OpenHaunt/node/hardware/ToDo-assets/crystal-caps-in-path.png

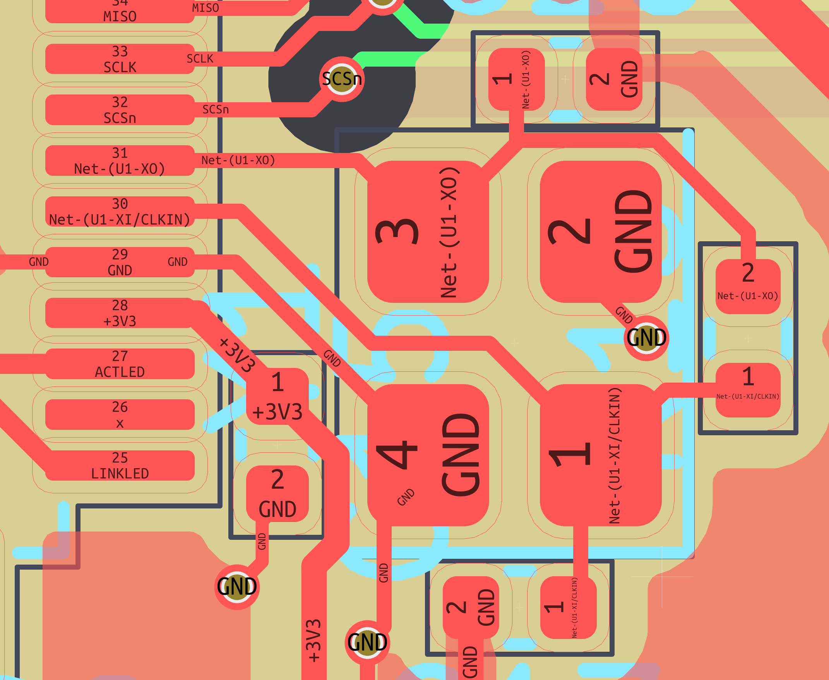
hardware/ToDo-assets/crystal-caps-in-path.png
