OpenHaunt/node/hardware/ToDo-assets/dangling-ends.png

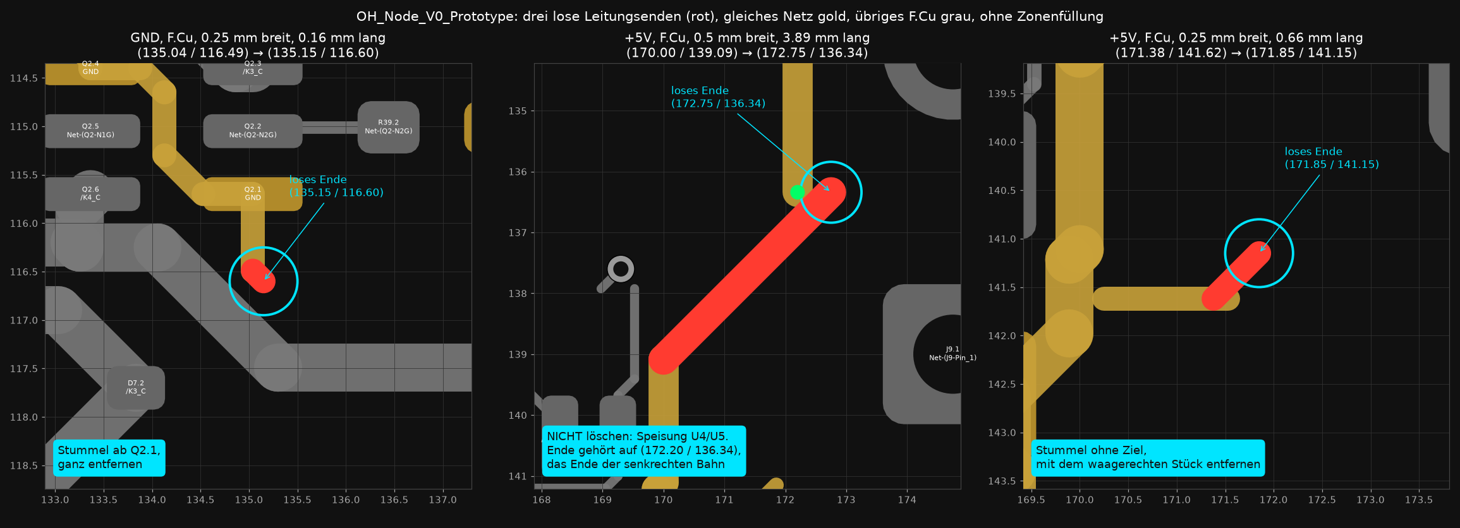
hardware/ToDo-assets/dangling-ends.png
