OpenHaunt/node/hardware/ToDo-assets/eth-pair-3v3a-via.png

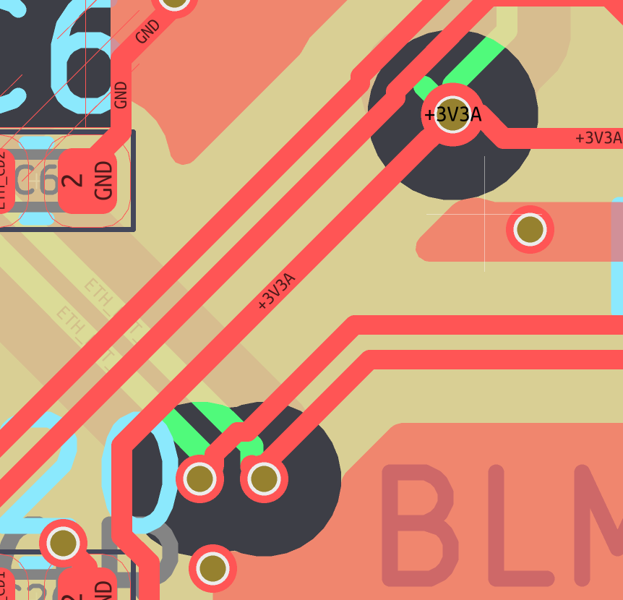
hardware/ToDo-assets/eth-pair-3v3a-via.png
