OpenHaunt/node/hardware/ToDo-assets/gnd-zone-settings.png

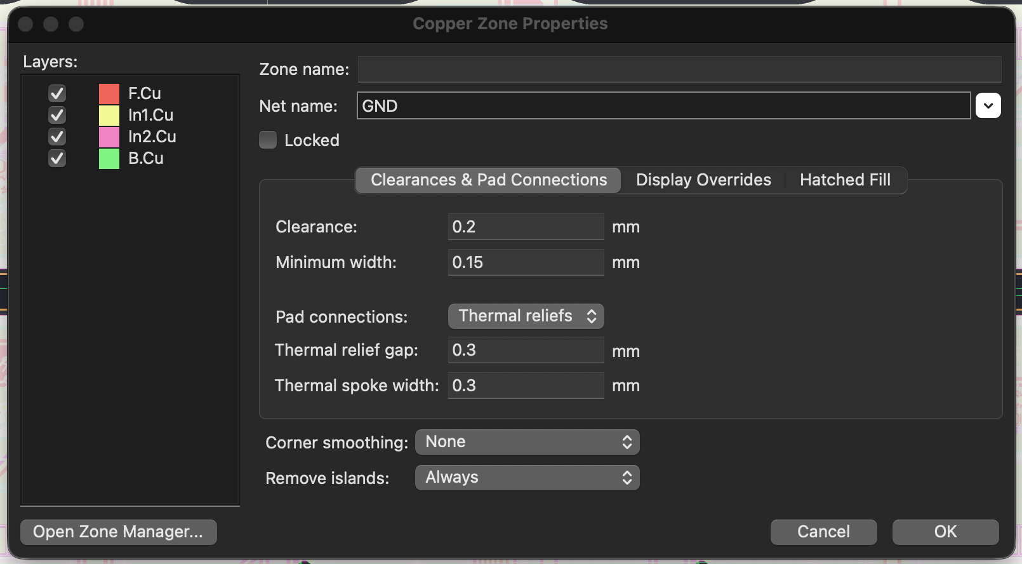
hardware/ToDo-assets/gnd-zone-settings.png
