OpenHaunt/node/hardware/ToDo-assets/k3-a1-connection.png

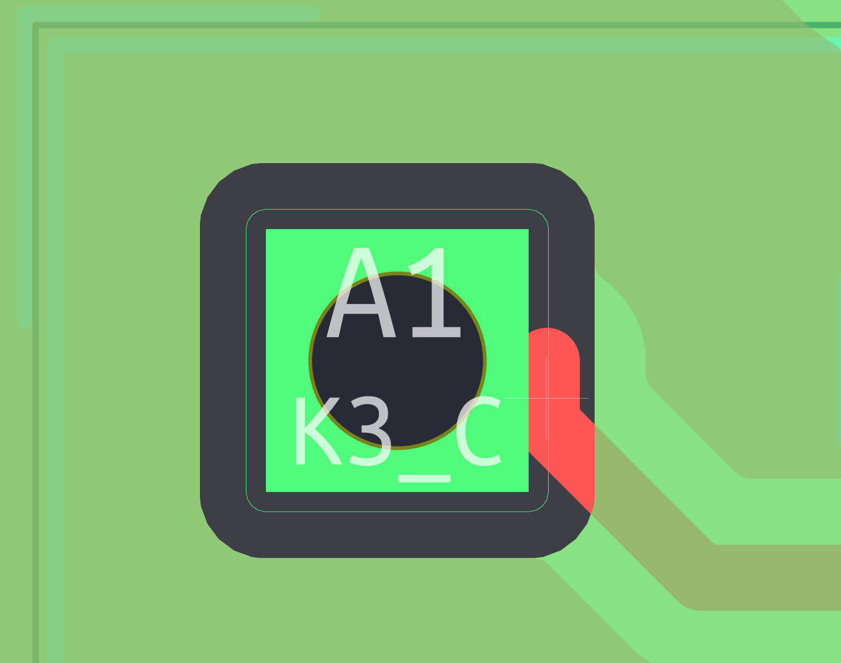
hardware/ToDo-assets/k3-a1-connection.png
