OpenHaunt/node/hardware/ToDo-assets/stitching-near-gnd-pads.png

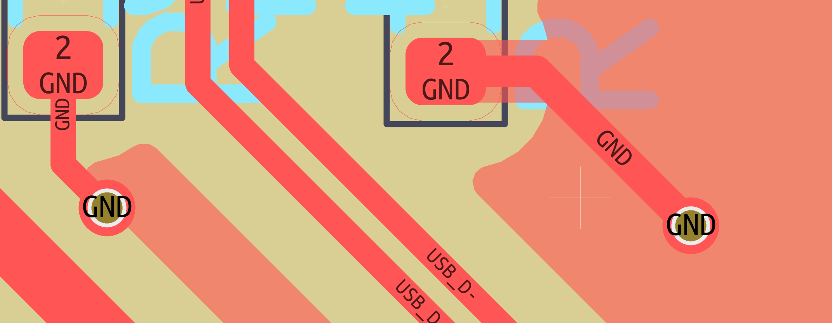
hardware/ToDo-assets/stitching-near-gnd-pads.png
