OpenHaunt/node/hardware/ToDo-assets/thin-traces-io0.png

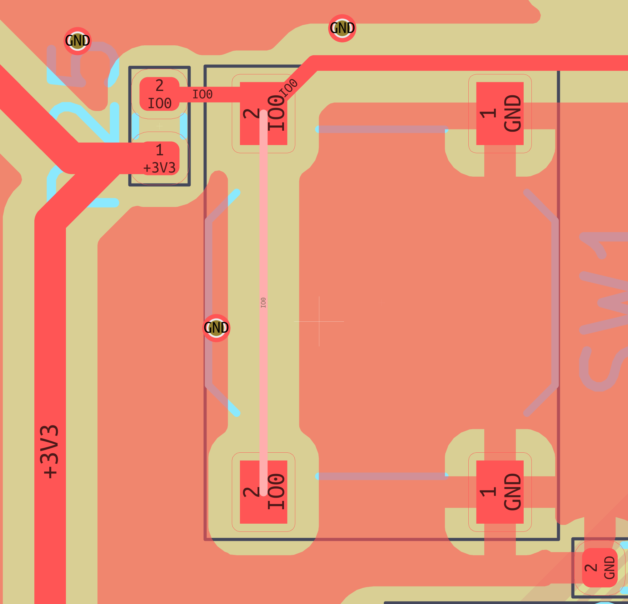
hardware/ToDo-assets/thin-traces-io0.png
