OpenHaunt/node/hardware/ToDo-assets/tvs-on-branch.png

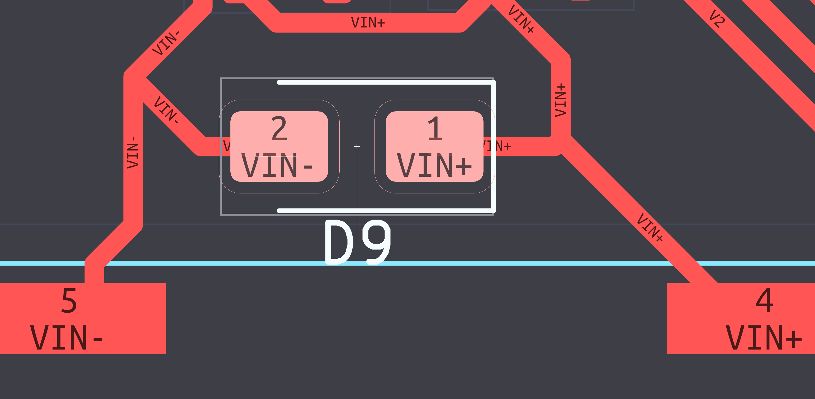
hardware/ToDo-assets/tvs-on-branch.png
