OpenHaunt/node/hardware/ToDo-assets/via-stitching-plugin.png

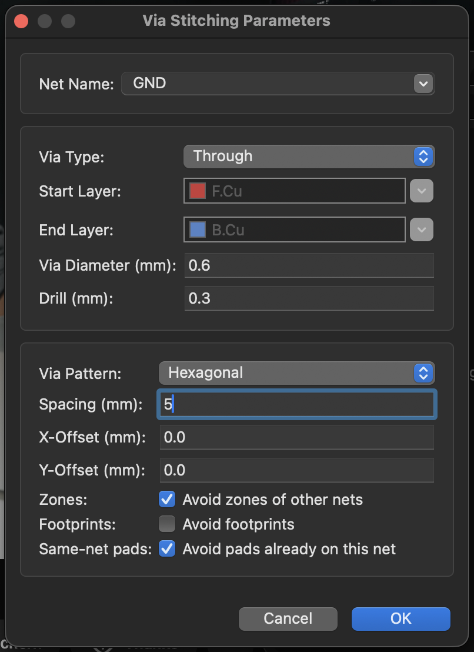
hardware/ToDo-assets/via-stitching-plugin.png
