OpenHaunt/node/hardware/ToDo-assets/zone-finger-corner.png

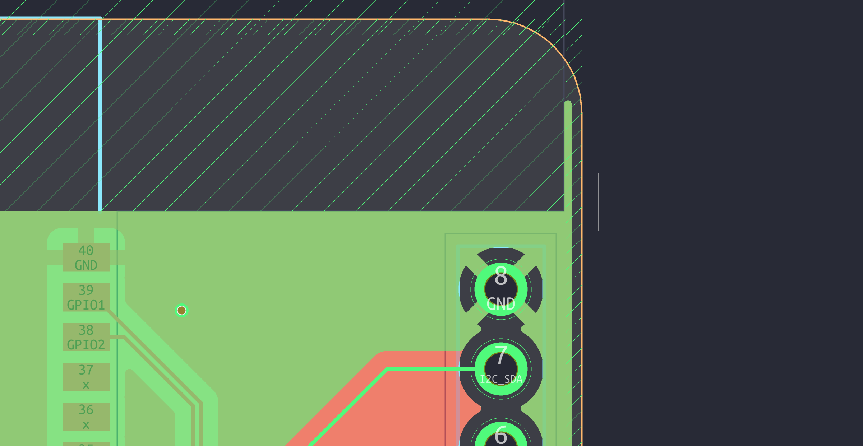
hardware/ToDo-assets/zone-finger-corner.png
