OpenHaunt/node/hardware/OH_Node_V0_Prototype/production/jlc_final/hand_parts.md

# Hand-soldered THT parts — 5 board(s), DigiKey prices (EUR) fetched 2026-10-17

Generated by `scripts/hand_parts.py --boards 5 --spares`. Order = needed + spares (1 from €5 unit price, 2 from €1, 3 below); cost = order × unit price at that quantity.

## From DigiKey

Cart upload: `hand_parts_digikey.csv`.

| Refs | Per board | Needed | Spares | Order | Part | Manufacturer | Part-DB | DigiKey | DK stock | € unit | € order |
|---|---|---|---|---|---|---|---|---|---|---|---|
| J1 | 1 | 5 | 3 | 8 | STX-3000 | Kycon, Inc. | 617 | 2092-STX-3000-ND | 59316 | 0.6 | 4.8 |
| K1, K2, K3, K4 | 4 | 20 | 2 | 22 | G2RL-1-E DC5 | Aratas (Formerly Omron Components) | 583 | Z2824-ND | 9626 | 3.21 | 70.62 |
| PS1 | 1 | 5 | 1 | 6 | AG9905-MTB | Silvertel | 577 | 5061-AG9905-MTB-ND | 6353 | 7.68 | 46.08 |

**DigiKey cost for 5 board(s): €121.50**, excl. shipping/VAT.

## From Würth Elektronik directly

Order list: `hand_parts_wurth.csv` (order code = MPN). The DigiKey prices are a reference only.

| Refs | Per board | Needed | Spares | Order | Part | Manufacturer | Part-DB | DigiKey | DK stock | € unit | € order |
|---|---|---|---|---|---|---|---|---|---|---|---|
| J2, J4, J5, J6, J8, J10 | 6 | 30 | 3 | 33 | 691137710003 | Würth Elektronik | 584 | 732-10956-ND | 14546 | 0.489 | 16.14 |
| J3 | 1 | 5 | 1 | 6 | 7499511420 | Würth Elektronik | 159 | 732-7499511420-ND | 84 | 13.756 | 82.54 |
| J7, J9, J13 | 3 | 15 | 3 | 18 | 691137710002 | Würth Elektronik | 585 | 732-10955-ND | 66147 | 0.303 | 5.45 |
| J12 | 1 | 5 | 3 | 8 | 61300811121 | Würth Elektronik | 34 | 732-5321-ND | 40836 | 0.33 | 2.64 |

Reference at DigiKey prices: €106.77.

Plus the enclosure hardware per board (4 × M2.5 × 25 screws through H1–H4, 4 × M2.5 heat-set inserts, wall screws): see `enclosure/v0.2/README.md`.

DNP, not fitted: R5, R9, R10, R11, R12, R13, R14, R47, R48, R50.
