OpenHaunt/node/hardware/OH_Node_V0_Prototype/production/jlc_final/bom.csv

Comment | Designator | Footprint | LCSC Part # | MPN
1n 2kV | C1 | C_1206_3216Metric | C9196 | 1206B102K202NT
100u/25V | C2 | CP_Elec_6.3x7.7 | C50146718 | FP-025ME101M-SAR
22u/25V | C3,C4,C25,C31,C34,C35,C36,C37 | C_0805_2012Metric | C45783 | CL21A226MAQNNNE
10u | C5,C27,C33,C43,C49,C50 | C_0402_1005Metric | C408132 | GRM155R61A106ME11D
100n/50V | C6,C7,C8,C9,C10,C11,C12,C15,C20,C26,C28,C29,C32,C38,C40,C41,C42,C44 | C_0402_1005Metric | C307331 | CL05B104KB54PNC
1u/25V | C13,C14,C24,C39,C51,C52 | C_0402_1005Metric | C52923 | CL05A105KA5NQNC
10n | C16,C30 | C_0402_1005Metric | C15195 | CL05B103KB5NNNC
27p | C17,C18 | C_0402_1005Metric | C1557 | 0402CG270J500NT
4.7u | C19 | C_0805_2012Metric | C1779 | CL21A475KAQNNNE
100u | C21 | C_1206_3216Metric | C883598 | GRM31CR61A107MEA8L
6n8 | C22,C23 | C_0402_1005Metric | C1542 | 0402B682K500NT
2u2 | C45,C48 | C_0603_1608Metric | C23630 | CL10A225KO8NNNC
2n2 | C46,C47 | C_0402_1005Metric | C1531 | 0402B222K500NT
KT-0603Y | D1 | LED_0603_1608Metric | C2287 | KT-0603Y
KT-0603R | D2,D3,D4,D14,D15 | LED_0603_1608Metric | C2286 | KT-0603R
1N4148WS | D5,D6,D7,D8,D18,D19 | D_SOD-323 | C2128 | 1N4148WS
SMAJ58A | D9 | D_SMA | C19077554 | SMAJ58A
MB10S-50MIL | D11,D12 | TO-269AA | C2488 | MB10S-50MIL
KT-0805Y | D16,D17 | LED_0805_2012Metric | C2296 | KT-0805Y
B5819W SL | D21 | D_SOD-123 | C8598 | B5819W SL
0805L020/30XR | F1,F2 | Fuse_0805_2012Metric | C7472560 | 0805L020/30XR
USB4215-03-A | J11 | USB_C_Receptacle_GCT_USB4215-xx-A_16P_TopMnt_Horizontal | C37616412 | USB4215-03-A
BLM15AG601SN1D | L1,L3 | L_0402_1005Metric | C76884 | BLM15AG601SN1D
10u | L2 | L_Sunlord_SWPA4030S | C38117 | SWPA4030S100MT
DMN2004DWK-7 | Q1,Q2 | SOT-363_SC-70-6 | C156343 | DMN2004DWK-7
MMBT3904 | Q3,Q4 | SOT-23 | C20526 | MMBT3904
1M | R1 | R_0603_1608Metric | C22935 | 0603WAF1004T5E
4K7 | R2,R3 | R_0402_1005Metric | C25900 | 0402WGF4701TCE
10R | R4 | R_0402_1005Metric | C25077 | 0402WGF100JTCE
5K1 | R6,R7 | R_0402_1005Metric | C25905 | 0402WGF5101TCE
12k4 | R8 | R_0402_1005Metric | C11692 | 0402WGF1242TCE
1M | R15 | R_0402_1005Metric | C26083 | 0402WGF1004TCE
0R | R16,R17,R18,R19 | R_0402_1005Metric | C17168 | 0402WGF0000TCE
10K | R20,R22,R23,R24,R25,R31,R32,R34,R35,R36,R37,R38,R41,R49,R58,R60,R61,R66,R70 | R_0402_1005Metric | C25744 | 0402WGF1002TCE
49R9 | R21,R42,R43,R44 | R_0402_1005Metric | C25120 | 0402WGF499JTCE
150R | R26,R27,R28,R33 | R_0402_1005Metric | C25082 | 0402WGF1500TCE
1K | R29,R30,R39,R40,R45,R46,R51,R52,R53,R54,R55,R56,R71 | R_0402_1005Metric | C11702 | 0402WGF1001TCE
100K | R57,R59 | R_0402_1005Metric | C25741 | 0402WGF1003TCE
470R | R62,R63 | R_0402_1005Metric | C25117 | 0402WGF4700TCE
51K | R64 | R_0603_1608Metric | C23196 | 0603WAF5102T5E
2K7 | R65 | R_0603_1608Metric | C13167 | 0603WAF2701T5E
47K | R67,R69 | R_0402_1005Metric | C25792 | 0402WGF4702TCE
12K | R68 | R_0402_1005Metric | C25752 | 0402WGF1202TCE
Push | SW1,SW2 | SW_Push_1P1T_XKB_TS-1187A | C318884 | TS-1187A-B-A-B
W5500 | U1 | LQFP-48_7x7mm_P0.5mm | C32843 | W5500
ESP32-S3-WROOM-1-N16R2 | U2 | Espressif_ESP32-S3-WROOM-1 | C2913205 | ESP32-S3-WROOM-1-N16R2
AMS1117-3.3 | U3 | SOT-223-3_TabPin2 | C347222 | AMS1117-3.3
74AHCT1G125W5-7 | U4,U5 | SOT-23-5 | C842287 | 74AHCT1G125W5-7
MAX98357AETE+T | U6 | TQFN-16-1EP_3x3mm_P0.5mm_EP1.23x1.23mm | C910544 | MAX98357AETE+T
MT3608 | U7 | SOT-23-6 | C84817 | MT3608
TPS2121RUXR | U8 | Texas_VQFN-HR-12_2x2.5mm_P0.5mm | C485916 | TPS2121RUXR
PCM5102APWR | U9 | TSSOP-20_4.4x6.5mm_P0.65mm | C107671 | PCM5102APWR
CJ431 | U10 | SOT-23 | C3113 | CJ431
ECS-250-18-33-JGN-TR3 | Y1 | Crystal_SMD_3225-4Pin_3.2x2.5mm | C5354421 | ECS-250-18-33-JGN-TR3
