OpenHaunt/node/hardware/OH_Node_V0_Prototype/production/jlc_final/hand_parts.csv

refs | qty_per_board | needed | spares | order | part | manufacturer | source | description | partdb_id | digikey_pn | digikey_stock | price_1 | unit_price | cost_needed | tiers
J1 | 1 | 5 | 3 | 8 | STX-3000 | Kycon, Inc. | DigiKey | 3.50mm (0.141", 1/8", Mini Plug) - Headphone Phone Jack Ster | 617 | 2092-STX-3000-ND | 59316 | 0.6 | 0.6 | 4.8 | 1:0.6; 10:0.505; 25:0.4728; 50:0.45; 100:0.4286; 250:0.40172; 500:0.38254; 1000:0.36426; 3000:0.33709
J2, J4, J5, J6, J8, J10 | 6 | 30 | 3 | 33 | 691137710003 | Würth Elektronik | Würth direct | 3 Position Wire to Board Terminal Block Horizontal with Boar | 584 | 732-10956-ND | 14546 | 0.55 | 0.489 | 16.14 | 1:0.55; 10:0.489; 50:0.4354; 100:0.3912; 500:0.37938
J3 | 1 | 5 | 1 | 6 | 7499511420 | Würth Elektronik | Würth direct | 1 Port RJ45 Through Hole 10/100/1000 Base-T, AutoMDIX, Power | 159 | 732-7499511420-ND | 84 | 14.43 | 13.756 | 82.54 | 1:14.43; 5:13.756; 10:13.338; 21:12.93238; 42:12.51976
J7, J9, J13 | 3 | 15 | 3 | 18 | 691137710002 | Würth Elektronik | Würth direct | 2 Position Wire to Board Terminal Block Horizontal with Boar | 585 | 732-10955-ND | 66147 | 0.33 | 0.303 | 5.45 | 1:0.33; 10:0.303; 50:0.267; 100:0.2394; 500:0.23298
J12 | 1 | 5 | 3 | 8 | 61300811121 | Würth Elektronik | Würth direct | Connector Header THT 8 position 2.54mm | 34 | 732-5321-ND | 40836 | 0.33 | 0.33 | 2.64 | 1:0.33; 10:0.28; 25:0.2336; 50:0.1952; 100:0.177
K1, K2, K3, K4 | 4 | 20 | 2 | 22 | G2RL-1-E DC5 | Aratas (Formerly Omron Components) | DigiKey | General Purpose Relay SPDT (1 Form C) 5VDC Coil Through Hole | 583 | Z2824-ND | 9626 | 3.73 | 3.21 | 70.62 | 1:3.73; 20:3.21; 40:3.10025; 60:3.03767; 100:2.9605; 260:2.82146; 500:2.72996; 1000:2.63616
PS1 | 1 | 5 | 1 | 6 | AG9905-MTB | Silvertel | DigiKey | Isolated PoE (Power over Ethernet) Module DC DC Converter 1 | 577 | 5061-AG9905-MTB-ND | 6353 | 7.68 | 7.68 | 46.08 | 1:7.68; 50:7.463; 100:7.2435; 500:7.02402; 1000:6.36554
