OpenHaunt/node/hardware/OH_Node_V0_Prototype/production/jlc_final/hand_parts_wurth.csv

Order Code | Description | Quantity | Customer Reference
691137710003 | 3 Position Wire to Board Terminal Block Horizontal with Boar | 33 | J2, J4, J5, J6, J8, J10
7499511420 | 1 Port RJ45 Through Hole 10/100/1000 Base-T, AutoMDIX, Power | 6 | J3
691137710002 | 2 Position Wire to Board Terminal Block Horizontal with Boar | 18 | J7, J9, J13
61300811121 | Connector Header THT 8 position 2.54mm | 8 | J12
