OpenHaunt/node/hardware/OH_Node_V0_Prototype/production/jlc_final/hand_parts_digikey.csv

Digi-Key Part Number | Manufacturer Part Number | Quantity | Customer Reference
2092-STX-3000-ND | STX-3000 | 8 | J1
Z2824-ND | G2RL-1-E DC5 | 22 | K1, K2, K3, K4
5061-AG9905-MTB-ND | AG9905-MTB | 6 | PS1
