OpenHaunt/node/hardware/OH_Node_V0_Prototype/enclosure/OH_Node_V0_3x0.2_enclosures.3mf

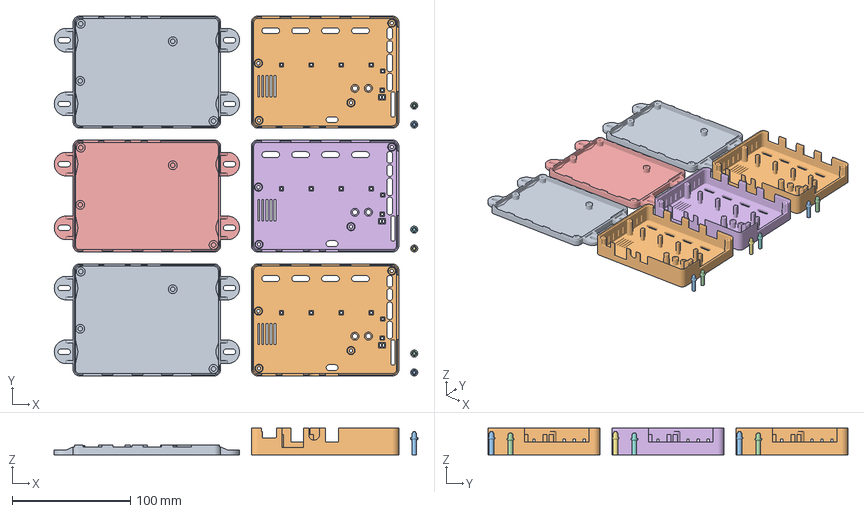
[picture p11: CAD file, 2026-11-02]
hardware/OH_Node_V0_Prototype/enclosure/OH_Node_V0_3x0.2_enclosures.3mf
308.0 x 305.0 x 22.5 mm
v0.2 A base
v0.2 A hood
v0.2 A pin BOOT
v0.2 A pin RST
v0.2 B base
v0.2 B hood
v0.2 B pin BOOT
v0.2 B pin RST
v0.2 C base
v0.2 C hood
v0.2 C pin BOOT
v0.2 C pin RST
