OpenHaunt/node/hardware/OH_Node_V0_Prototype/enclosure/v0.2/OH_Node_V0.2_enclosure.3mf

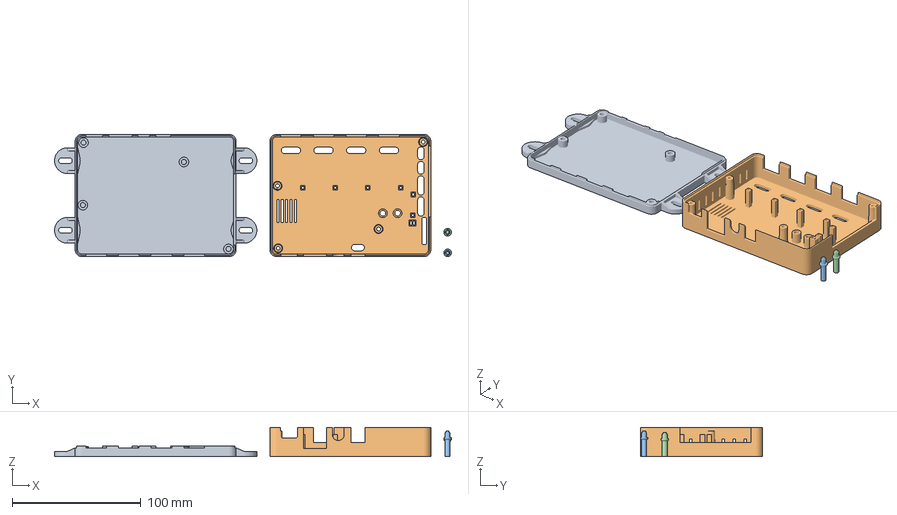
[picture p12: CAD file, 2026-11-02]
hardware/OH_Node_V0_Prototype/enclosure/v0.2/OH_Node_V0.2_enclosure.3mf
308.0 x 95.0 x 22.5 mm
base
hood
pin BOOT
pin RST
