OpenHaunt/node/hardware/OH_Node_V0_Prototype/enclosure/OH_Node_V0_2x0.2_1x0.1_enclosures.3mf

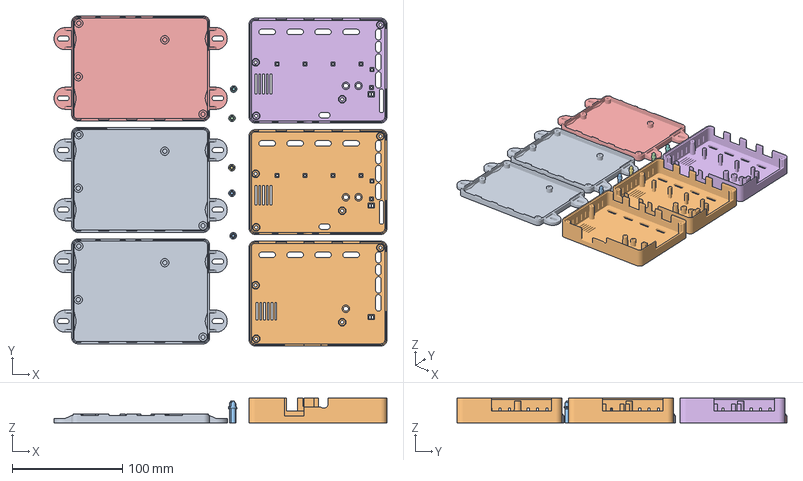
[picture p13: CAD file, 2026-11-02]
hardware/OH_Node_V0_Prototype/enclosure/OH_Node_V0_2x0.2_1x0.1_enclosures.3mf
301.7 x 298.9 x 22.5 mm
v0.2 A base
v0.2 A hood
v0.2 A pin BOOT
v0.2 A pin RST
v0.2 B base
v0.2 B hood
v0.2 B pin BOOT
v0.2 B pin RST
v0.1 base
v0.1 hood
v0.1 pin
