OpenHaunt/node/hardware/OH_Node_V0_Prototype/enclosure/v0.1/OH_Node_V0.1_enclosure.3mf

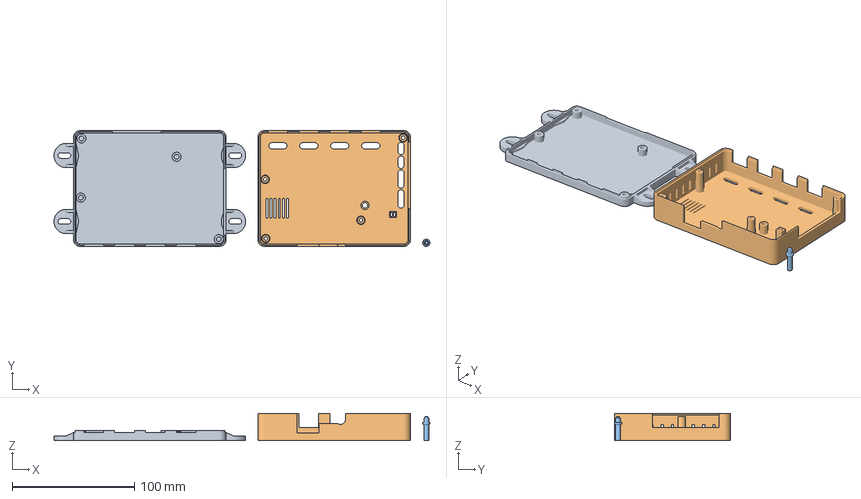
[picture p14: CAD file, 2026-11-02, an earlier design]
hardware/OH_Node_V0_Prototype/enclosure/v0.1/OH_Node_V0.1_enclosure.3mf
308.0 x 95.0 x 22.5 mm
base
hood
pin
