OpenHaunt/node/(list of files, cad)

Other CAD files:
hardware/OH_Node_V0_Prototype/enclosure/v0.1/enclosure.scad
