OpenHaunt/node/hardware/ToDo-assets/single-via-layer-changes.png

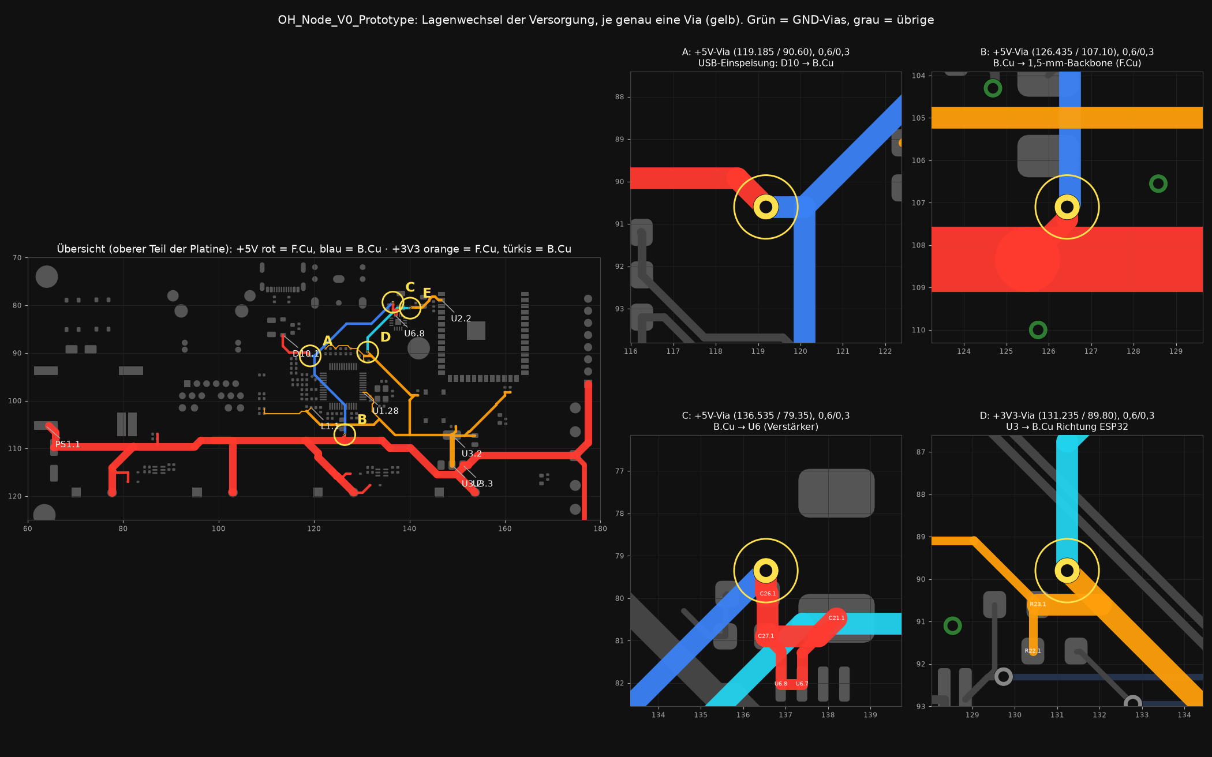
hardware/ToDo-assets/single-via-layer-changes.png
