OpenHaunt/node/hardware/OH_Node_V0_Prototype/OH_Node_V0_Prototype.kicad_pcb

## KiCad design hardware/OH_Node_V0_Prototype/OH_Node_V0_Prototype.kicad_pcb (2026-10-17)

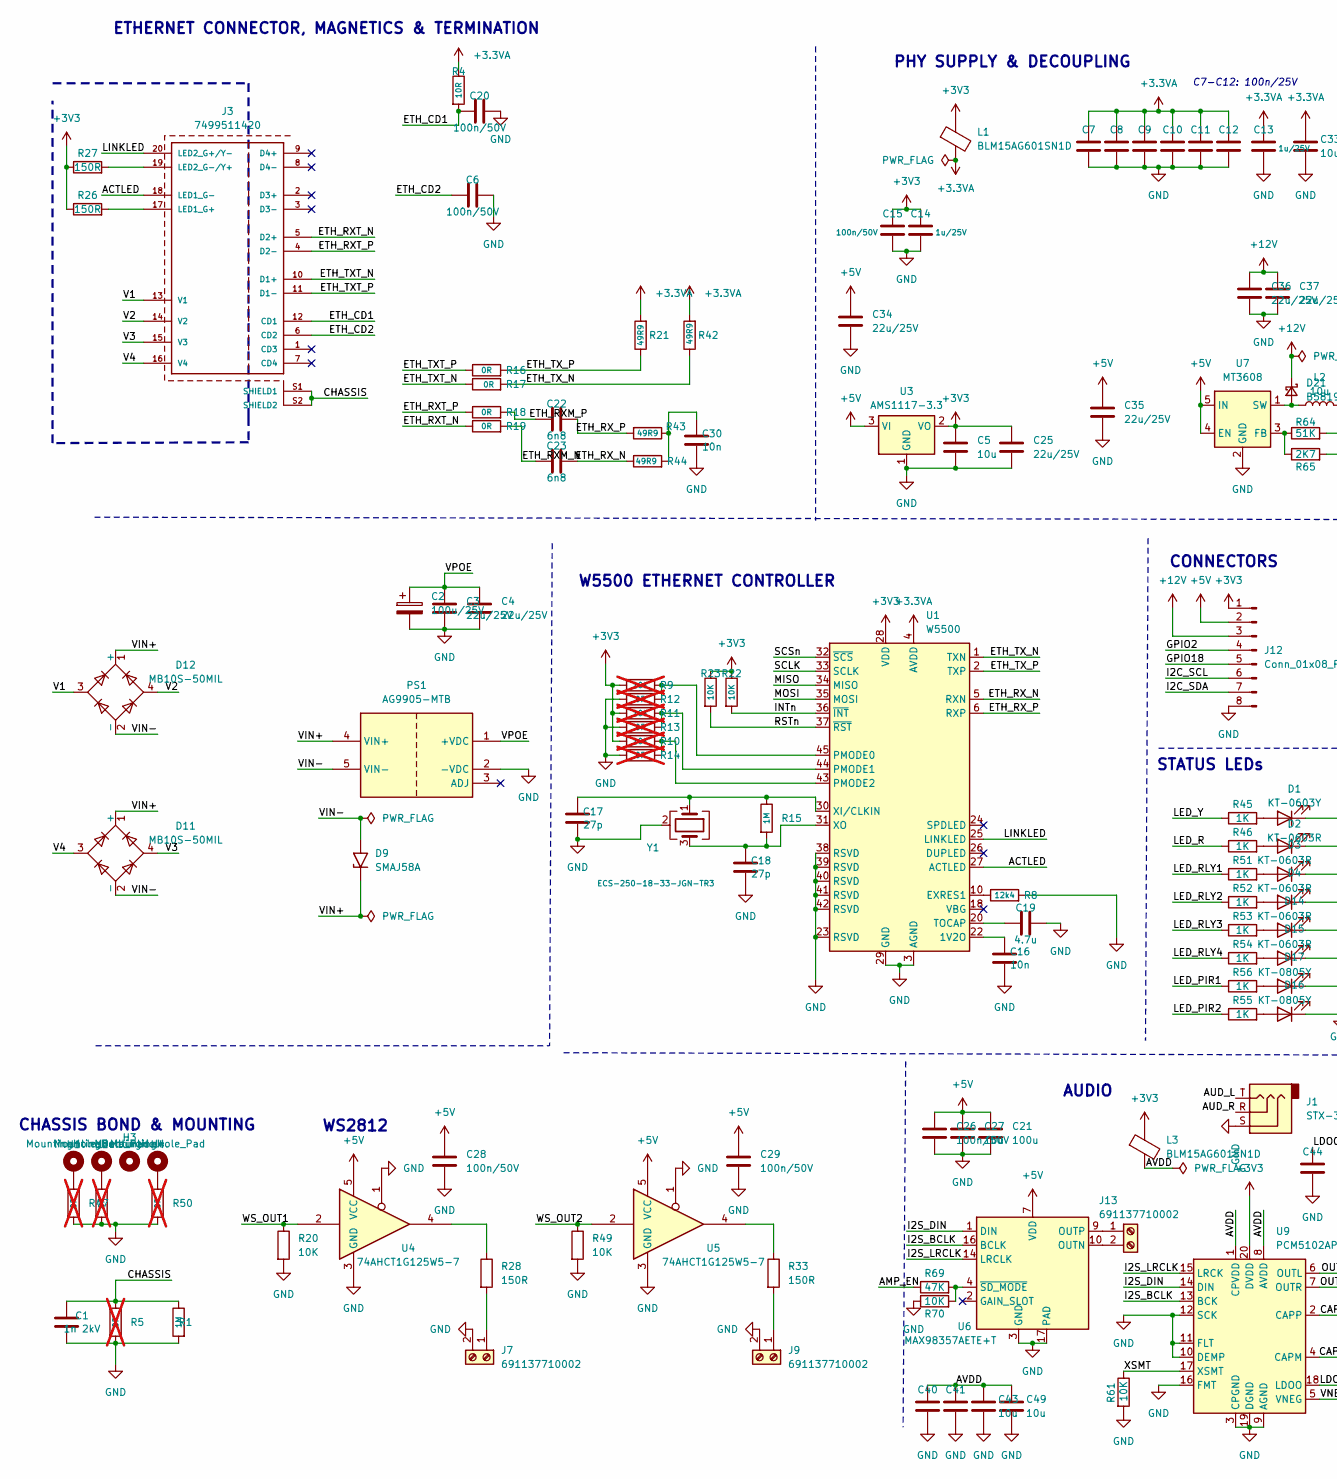
[picture p16: schematic OH_Node_V0_Prototype.kicad_sch, part in row 1, column 1]

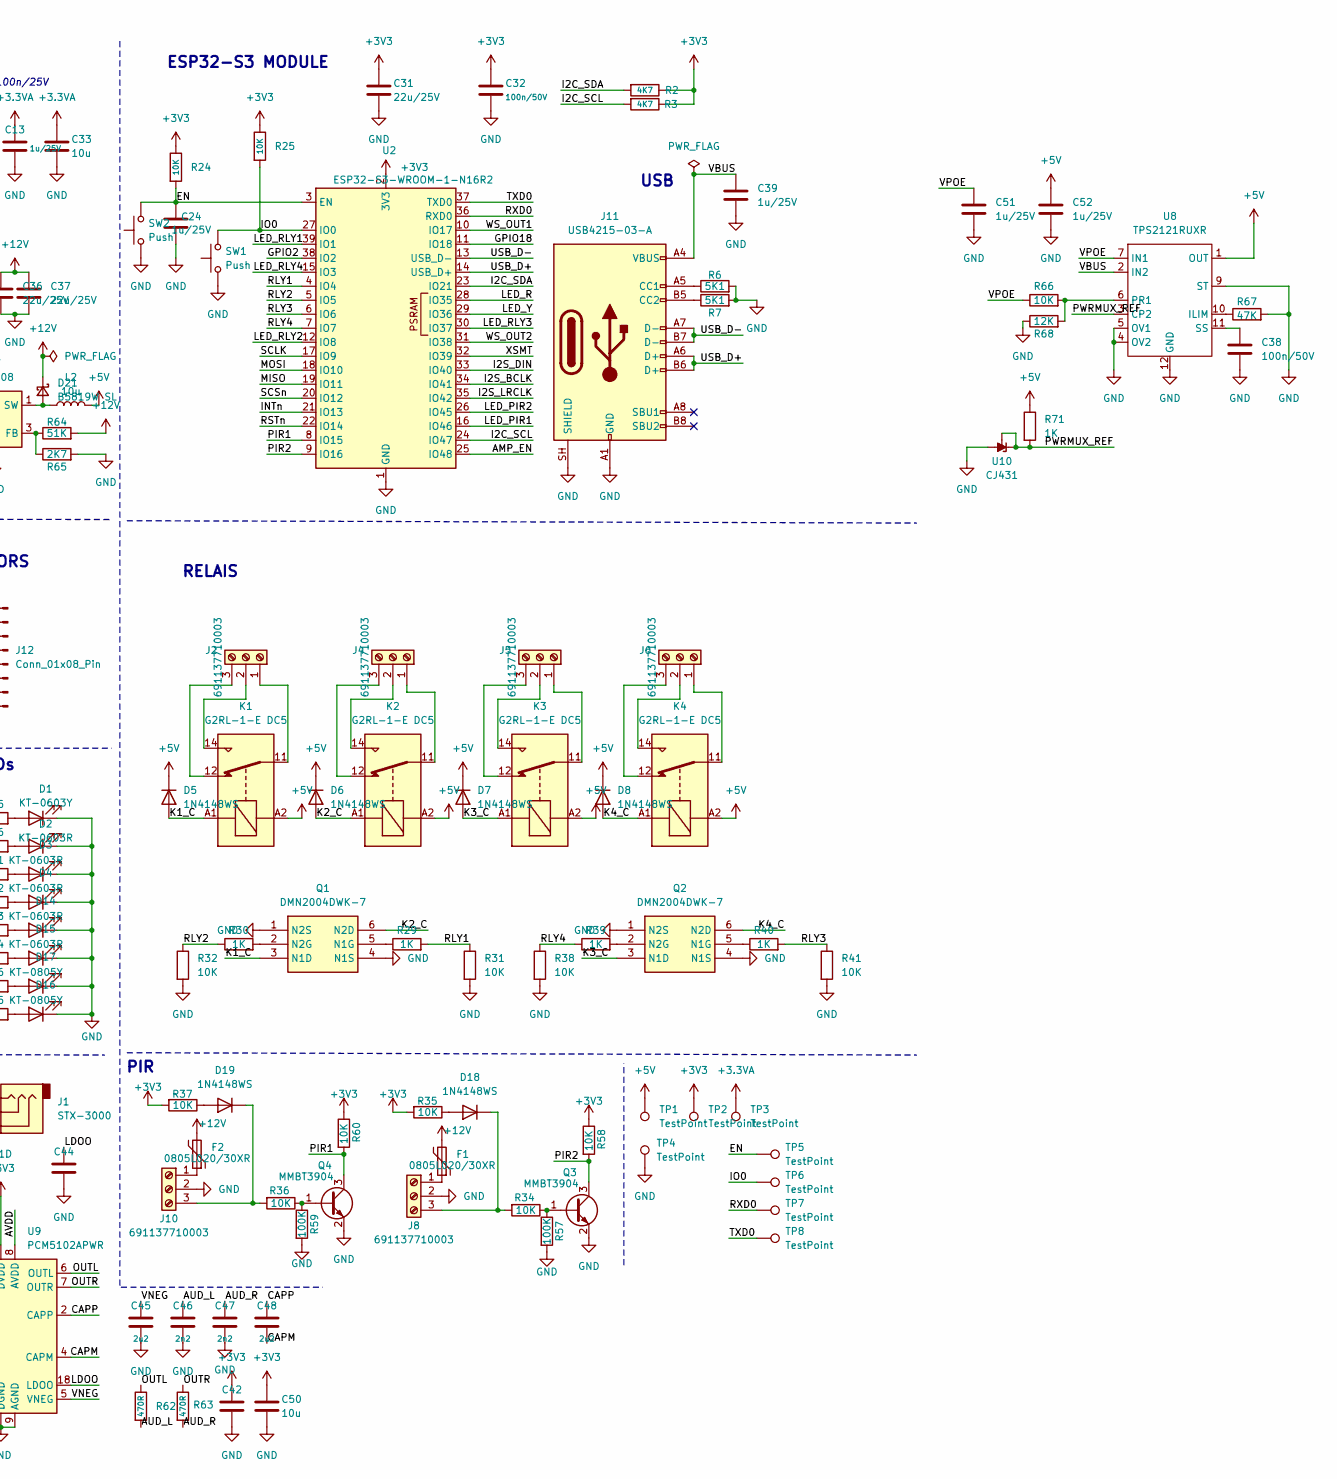
[picture p17: schematic OH_Node_V0_Prototype.kicad_sch, part in row 1, column 2]

Parts:
C1: 1n 2kV; C_1206_3216Metric; MPN 1206B102K202NT
C2: 100u/25V; CP_Elec_6.3x7.7; MPN FP-025ME101M-SAR
C3, C4, C25, C31, C34, C35, C36, C37: 22u/25V; C_0805_2012Metric; MPN CL21A226MAQNNNE
C5, C27, C33, C43, C49, C50: 10u; C_0402_1005Metric; MPN GRM155R61A106ME11D
C6, C7, C8, C9, C10, C11, C12, C15, C20, C26, C28, C29, C32, C38, C40, C41, C42, C44: 100n/50V; C_0402_1005Metric; MPN CL05B104KB54PNC
C13, C14, C24, C39, C51, C52: 1u/25V; C_0402_1005Metric; MPN CL05A105KA5NQNC
C16, C30: 10n; C_0402_1005Metric; MPN CL05B103KB5NNNC
C17, C18: 27p; C_0402_1005Metric; MPN 0402CG270J500NT
C19: 4.7u; C_0805_2012Metric; MPN CL21A475KAQNNNE
C21: 100u; C_1206_3216Metric; MPN GRM31CR61A107MEA8L
C22, C23: 6n8; C_0402_1005Metric; MPN 0402B682K500NT
C45, C48: 2u2; C_0603_1608Metric; MPN CL10A225KO8NNNC
C46, C47: 2n2; C_0402_1005Metric; MPN 0402B222K500NT
D1: KT-0603Y; LED_0603_1608Metric; MPN KT-0603Y
D2, D3, D4, D14, D15: KT-0603R; LED_0603_1608Metric; MPN KT-0603R
D5, D6, D7, D8, D18, D19: 1N4148WS; D_SOD-323; MPN 1N4148WS
D9: SMAJ58A; D_SMA; MPN SMAJ58A
D11, D12: MB10S-50MIL; TO-269AA; MPN MB10S-50MIL
D16, D17: KT-0805Y; LED_0805_2012Metric; MPN KT-0805Y
D21: B5819W SL; D_SOD-123; MPN B5819W SL
F1, F2: 0805L020/30XR; Fuse_0805_2012Metric; MPN 0805L020/30XR
H1, H2, H4: MountingHole_Pad; MountingHole_2.7mm_M2.5_DIN965_Pad
H3: MountingHole; MountingHole_2.7mm_M2.5_DIN965_Pad
J1: STX-3000; Jack_3.5mm_Kycon_STX-3000_Horizontal; MPN STX-3000
J2, J4, J5, J6, J8, J10: 691137710003; WR-TBL_691137710003; MPN 691137710003
J3: 7499511420; WE-RJ45_7499511420; MPN 7499511420
J7, J9, J13: 691137710002; WR-TBL_691137710002; MPN 691137710002
J11: USB4215-03-A; USB_C_Receptacle_GCT_USB4215-xx-A_16P_TopMnt_Horizontal; MPN USB4215-03-A
J12: Conn_01x08_Pin; PinHeader_1x08_P2.54mm_Vertical; MPN 61300811121
K1, K2, K3, K4: G2RL-1-E DC5; Relay_SPDT_Omron_G2RL-1-E; MPN G2RL-1-E DC5
L1, L3: BLM15AG601SN1D; L_0402_1005Metric; MPN BLM15AG601SN1D
L2: 10u; L_Sunlord_SWPA4030S; MPN SWPA4030S100MT
PS1: AG9905-MTB; AG9900-MTB_HandSolder; MPN AG9905-MTB
Q1, Q2: DMN2004DWK-7; SOT-363_SC-70-6; MPN DMN2004DWK-7
Q3, Q4: MMBT3904; SOT-23; MPN MMBT3904
R1: 1M; R_0603_1608Metric; MPN 0603WAF1004T5E
R2, R3: 4K7; R_0402_1005Metric; MPN 0402WGF4701TCE
R4: 10R; R_0402_1005Metric; MPN 0402WGF100JTCE
R5, R12, R13, R14, R47, R48, R50: 0R; R_0402_1005Metric; MPN 0402WGF0000TCE; not fitted
R6, R7: 5K1; R_0402_1005Metric; MPN 0402WGF5101TCE
R8: 12k4; R_0402_1005Metric; MPN 0402WGF1242TCE
R9, R10, R11: 10K; R_0402_1005Metric; MPN 0402WGF1002TCE; not fitted
R15: 1M; R_0402_1005Metric; MPN 0402WGF1004TCE
R16, R17, R18, R19: 0R; R_0402_1005Metric; MPN 0402WGF0000TCE
R20, R22, R23, R24, R25, R31, R32, R34, R35, R36, R37, R38, R41, R49, R58, R60, R61, R66, R70: 10K; R_0402_1005Metric; MPN 0402WGF1002TCE
R21, R42, R43, R44: 49R9; R_0402_1005Metric; MPN 0402WGF499JTCE
R26, R27, R28, R33: 150R; R_0402_1005Metric; MPN 0402WGF1500TCE
R29, R30, R39, R40, R45, R46, R51, R52, R53, R54, R55, R56, R71: 1K; R_0402_1005Metric; MPN 0402WGF1001TCE
R57, R59: 100K; R_0402_1005Metric; MPN 0402WGF1003TCE
R62, R63: 470R; R_0402_1005Metric; MPN 0402WGF4700TCE
R64: 51K; R_0603_1608Metric; MPN 0603WAF5102T5E
R65: 2K7; R_0603_1608Metric; MPN 0603WAF2701T5E
R67, R69: 47K; R_0402_1005Metric; MPN 0402WGF4702TCE
R68: 12K; R_0402_1005Metric; MPN 0402WGF1202TCE
SW1, SW2: Push; SW_Push_1P1T_XKB_TS-1187A; MPN TS-1187A-B-A-B
TP1, TP2, TP3, TP4, TP5, TP6, TP7, TP8: TestPoint; TestPoint_Pad_D1.5mm
U1: W5500; LQFP-48_7x7mm_P0.5mm; MPN W5500
U2: ESP32-S3-WROOM-1-N16R2; Espressif_ESP32-S3-WROOM-1; MPN ESP32-S3-WROOM-1-N16R2
U3: AMS1117-3.3; SOT-223-3_TabPin2; MPN AMS1117-3.3
U4, U5: 74AHCT1G125W5-7; SOT-23-5; MPN 74AHCT1G125W5-7
U6: MAX98357AETE+T; TQFN-16-1EP_3x3mm_P0.5mm_EP1.23x1.23mm; MPN MAX98357AETE+T
U7: MT3608; SOT-23-6; MPN MT3608
U8: TPS2121RUXR; Texas_VQFN-HR-12_2x2.5mm_P0.5mm; MPN TPS2121RUXR
U9: PCM5102APWR; TSSOP-20_4.4x6.5mm_P0.65mm; MPN PCM5102APWR
U10: CJ431; SOT-23; MPN CJ431
Y1: ECS-250-18-33-JGN-TR3; Crystal_SMD_3225-4Pin_3.2x2.5mm; MPN ECS-250-18-33-JGN-TR3

Connections:
+3.3VA: C7.1, C8.1, C9.1, C10.1, C11.1, C12.1, C13.1, C33.1, L1.2, R4.1, R21.2, R42.2, TP3.1 (1_1), U1.4 (AVDD), U1.8 (AVDD), U1.11 (AVDD), U1.15 (AVDD), U1.17 (AVDD), U1.21 (AVDD)
+3V3: C5.1, C14.1, C15.1, C25.1, C31.1, C32.1, C42.1, C50.1, J12.1, L1.1, L3.1, R2.1, R3.1, R9.1, R10.1, R11.1, R22.1, R23.1, R24.1, R25.1, R26.1, R27.1, R35.2, R37.2, R58.1, R60.1, TP2.1 (1_1), U1.28 (VDD), U2.2 (3V3), U3.2 (VO), U9.20 (DVDD)
+5V: C21.1, C26.1, C27.1, C28.1, C29.1, C34.1, C35.1, C52.1, D5.1 (K), D6.1 (K), D7.1 (K), D8.1 (K), J12.2, K1.A2, K2.A2, K3.A2, K4.A2, L2.2, R71.1, TP1.1 (1_1), U3.3 (VI), U4.5 (VCC), U5.5 (VCC), U6.7 (VDD), U6.8 (VDD), U7.4 (EN), U7.5 (IN), U8.1 (OUT), U8.8 (OUT)
+12V: C36.1, C37.1, D21.1 (K), F1.2, F2.2, J12.3, R64.2
/ACTLED: J3.18 (LED1_G-), U1.27 (ACTLED)
/AMP_EN: R69.1, U2.25 (IO48)
/AUD_L: C46.1, J1.T, R62.2
/AUD_R: C47.1, J1.R, R63.2
/AVDD: C40.1, C41.1, C43.1, C49.1, L3.2, U9.1 (CPVDD), U9.8 (AVDD)
/CAPM: C48.2, U9.4 (CAPM)
/CAPP: C48.1, U9.2 (CAPP)
/CHASSIS: C1.1, J3.S1 (SHIELD1), J3.S2 (SHIELD2), R1.1, R5.1
/EN: C24.1, R24.2, SW2.2, TP5.1 (1_1), U2.3 (EN)
/ETH_CD1: C20.1, J3.12 (CD1), R4.2
/ETH_CD2: C6.1, J3.6 (CD2)
/ETH_RXM_N: C23.1, R19.2
/ETH_RXM_P: C22.1, R18.2
/ETH_RXT_N: J3.5 (D2+), R19.1
/ETH_RXT_P: J3.4 (D2-), R18.1
/ETH_RX_N: C23.2, R44.1, U1.5 (RXN)
/ETH_RX_P: C22.2, R43.2, U1.6 (RXP)
/ETH_TXT_N: J3.10 (D1+), R17.1
/ETH_TXT_P: J3.11 (D1-), R16.1
/ETH_TX_N: R17.2, R42.1, U1.1 (TXN)
/ETH_TX_P: R16.2, R21.1, U1.2 (TXP)
/GPIO2: J12.4, U2.38 (IO2)
/GPIO18: J12.5, U2.11 (IO18)
/I2C_SCL: J12.6, R3.2, U2.24 (IO47)
/I2C_SDA: J12.7, R2.2, U2.23 (IO21)
/I2S_BCLK: U2.34 (IO41), U6.16 (BCLK), U9.13 (BCK)
/I2S_DIN: U2.33 (IO40), U6.1 (DIN), U9.14 (DIN)
/I2S_LRCLK: U2.35 (IO42), U6.14 (LRCLK), U9.15 (LRCK)
/INTn: R22.2, U1.36 (~INT), U2.21 (IO13)
/IO0: R25.2, SW1.2, TP6.1 (1_1), U2.27 (IO0)
/K1_C: D5.2 (A), K1.A1, Q1.3 (N1D)
/K2_C: D6.2 (A), K2.A1, Q1.6 (N2D)
/K3_C: D7.2 (A), K3.A1, Q2.3 (N1D)
/K4_C: D8.2 (A), K4.A1, Q2.6 (N2D)
/LDOO: C44.1, U9.18 (LDOO)
/LED_PIR1: R56.1, U2.16 (IO46)
/LED_PIR2: R55.1, U2.26 (IO45)
/LED_R: R46.1, U2.28 (IO35)
/LED_RLY1: R51.1, U2.39 (IO1)
/LED_RLY2: R52.1, U2.12 (IO8)
/LED_RLY3: R53.1, U2.30 (IO37)
/LED_RLY4: R54.1, U2.15 (IO3)
/LED_Y: R45.1, U2.29 (IO36)
/LINKLED: J3.20 (LED2_G+/Y-), U1.25 (LINKLED)
/MISO: U1.34 (MISO), U2.19 (IO11)
/MOSI: U1.35 (MOSI), U2.18 (IO10)
/OUTL: R62.1, U9.6 (OUTL)
/OUTR: R63.1, U9.7 (OUTR)
/PIR1: Q4.3 (C), R60.2, U2.8 (IO15)
/PIR2: Q3.3 (C), R58.2, U2.9 (IO16)
/PWRMUX_REF: R71.2, U8.3 (CP2), U10.1 (REF), U10.2 (K)
/RLY1: R29.2, R31.1, U2.4 (IO4)
/RLY2: R30.1, R32.1, U2.5 (IO5)
/RLY3: R40.2, R41.1, U2.6 (IO6)
/RLY4: R38.1, R39.1, U2.7 (IO7)
/RSTn: R23.2, U1.37 (~RST), U2.22 (IO14)
/RXD0: TP7.1 (1_1), U2.36 (RXD0)
/SCLK: U1.33 (SCLK), U2.17 (IO9)
/SCSn: U1.32 (~SCS), U2.20 (IO12)
/TXD0: TP8.1 (1_1), U2.37 (TXD0)
/USB_D+: J11.A6 (D+), J11.B6 (D+), U2.14 (USB_D+)
/USB_D-: J11.A7 (D-), J11.B7 (D-), U2.13 (USB_D-)
/V1: D12.3, J3.13 (V1)
/V2: D12.4, J3.14 (V2)
/V3: D11.4, J3.15 (V3)
/V4: D11.3, J3.16 (V4)
/VBUS: C39.1, J11.A4 (VBUS), J11.A9 (VBUS), J11.B4 (VBUS), J11.B9 (VBUS), U8.2 (IN2)
/VIN+: D9.1 (A1), D11.1 (+), D12.1 (+), PS1.4 (VIN+)
/VIN-: D9.2 (A2), D11.2 (-), D12.2 (-), PS1.5 (VIN-)
/VNEG: C45.1, U9.5 (VNEG)
/VPOE: C2.1, C3.1, C4.1, C51.1, PS1.1 (+VDC), R66.1, U8.7 (IN1)
/WS_OUT1: R20.1, U2.10 (IO17), U4.2
/WS_OUT2: R49.1, U2.31 (IO38), U5.2
/XSMT: R61.1, U2.32 (IO39), U9.17 (XSMT)
GND: C1.2, C2.2, C3.2, C4.2, C5.2, C6.2, C7.2, C8.2, C9.2, C10.2, C11.2, C12.2, C13.2, C14.2, C15.2, C16.2, C17.2, C18.2, C19.2, C20.2, C21.2, C24.2, C25.2, C26.2, C27.2, C28.2, C29.2, C30.2, C31.2, C32.2, C33.2, C34.2, C35.2, C36.2, C37.2, C38.2, C39.2, C40.2, C41.2, C42.2, C43.2, C44.2, C45.2, C46.2, C47.2, C49.2, C50.2, C51.2, C52.2, D1.1 (K), D2.1 (K), D3.1 (K), D4.1 (K), D14.1 (K), D15.1 (K), D16.1 (K), D17.1 (K), J1.S, J7.2, J8.2, J9.2, J10.2, J11.A1 (GND), J11.A12 (GND), J11.B1 (GND), J11.B12 (GND), J11.SH (SHIELD), J12.8, PS1.2 (-VDC), Q1.1 (N2S), Q1.4 (N1S), Q2.1 (N2S), Q2.4 (N1S), Q3.2 (E), Q4.2 (E), R1.2, R5.2, R6.2, R7.2, R8.2, R12.1, R13.1, R14.1, R20.2, R31.2, R32.2, R38.2, R41.2, R47.2, R48.2, R49.2, R50.2, R57.2, R59.2, R61.2, R65.2, R67.2, R68.1, R70.1, SW1.1, SW2.1, TP4.1 (1_1), U1.3 (AGND), U1.9 (AGND), U1.14 (AGND), U1.16 (AGND), U1.19 (AGND), U1.23 (RSVD), U1.29 (GND), U1.38 (RSVD), U1.39 (RSVD), U1.40 (RSVD), U1.41 (RSVD), U1.42 (RSVD), U1.48 (AGND), U2.1 (GND), U2.40 (GND), U2.41 (GND), U3.1 (GND), U4.1, U4.3 (GND), U5.1, U5.3 (GND), U6.3 (GND), U6.11 (GND), U6.15 (GND), U6.17 (PAD), U7.2 (GND), U8.4 (OV2), U8.5 (OV1), U8.9 (ST), U8.12 (GND), U9.3 (CPGND), U9.9 (AGND), U9.10 (DEMP), U9.11 (FLT), U9.12 (SCK), U9.16 (FMT), U9.19 (DGND), U10.3 (A), Y1.2 (G), Y1.4 (G)
unnamed: C30.1, R43.1, R44.2
unnamed: D1.2 (A), R45.2
unnamed: D2.2 (A), R46.2
unnamed: D3.2 (A), R51.2
unnamed: D4.2 (A), R52.2
unnamed: D14.2 (A), R53.2
unnamed: D15.2 (A), R54.2
unnamed: D16.2 (A), R55.2
unnamed: D17.2 (A), R56.2
unnamed: D18.2 (A), R35.1
unnamed: D18.1 (K), J8.3, R34.2
unnamed: D19.2 (A), R37.1
unnamed: D19.1 (K), J10.3, R36.2
unnamed: D21.2 (A), L2.1, U7.1 (SW)
unnamed: H1.1 (1_1), R47.1
unnamed: H2.1 (1_1), R48.1
unnamed: H4.1 (1_1), R50.1
unnamed: J2.1, K1.11
unnamed: J2.2, K1.14
unnamed: J2.3, K1.12
unnamed: J3.17 (LED1_G+), R26.2
unnamed: J3.19 (LED2_G-/Y+), R27.2
unnamed: J4.1, K2.11
unnamed: J4.2, K2.14
unnamed: J4.3, K2.12
unnamed: J5.1, K3.11
unnamed: J5.2, K3.14
unnamed: J5.3, K3.12
unnamed: J6.1, K4.11
unnamed: J6.2, K4.14
unnamed: J6.3, K4.12
unnamed: J7.1, R28.2
unnamed: F1.1, J8.1
unnamed: J9.1, R33.2
unnamed: F2.1, J10.1
unnamed: J11.A5 (CC1), R6.1
unnamed: J11.B5 (CC2), R7.1
unnamed: J13.1, U6.9 (OUTP)
unnamed: J13.2, U6.10 (OUTN)
unnamed: Q1.5 (N1G), R29.1
unnamed: Q1.2 (N2G), R30.2
unnamed: Q2.5 (N1G), R40.1
unnamed: Q2.2 (N2G), R39.2
unnamed: Q3.1 (B), R34.1, R57.1
unnamed: Q4.1 (B), R36.1, R59.1
unnamed: R28.1, U4.4
unnamed: R33.1, U5.4
unnamed: C16.1, U1.22 (1V2O)
unnamed: R8.1, U1.10 (EXRES1)
unnamed: R9.2, R12.2, U1.45 (PMODE0)
unnamed: R11.2, R13.2, U1.44 (PMODE1)
unnamed: R10.2, R14.2, U1.43 (PMODE2)
unnamed: C19.1, U1.20 (TOCAP)
unnamed: C17.1, R15.1, U1.30 (XI/CLKIN), Y1.1
unnamed: C18.1, R15.2, U1.31 (XO), Y1.3
unnamed: R69.2, R70.2, U6.4 (~SD_MODE)
unnamed: R64.1, R65.1, U7.3 (FB)
unnamed: R67.1, U8.10 (ILIM)
unnamed: R66.2, R68.2, U8.6 (PR1)
unnamed: C38.1, U8.11 (SS)

Notes on the sheet:
C7-C12: 100n/25V
ETHERNET CONNECTOR, MAGNETICS & TERMINATION
PIR
USB
ESP32-S3 MODULE
PHY SUPPLY & DECOUPLING
AUDIO
RELAIS
W5500 ETHERNET CONTROLLER
CONNECTORS
WS2812
CHASSIS BOND & MOUNTING
STATUS LEDs

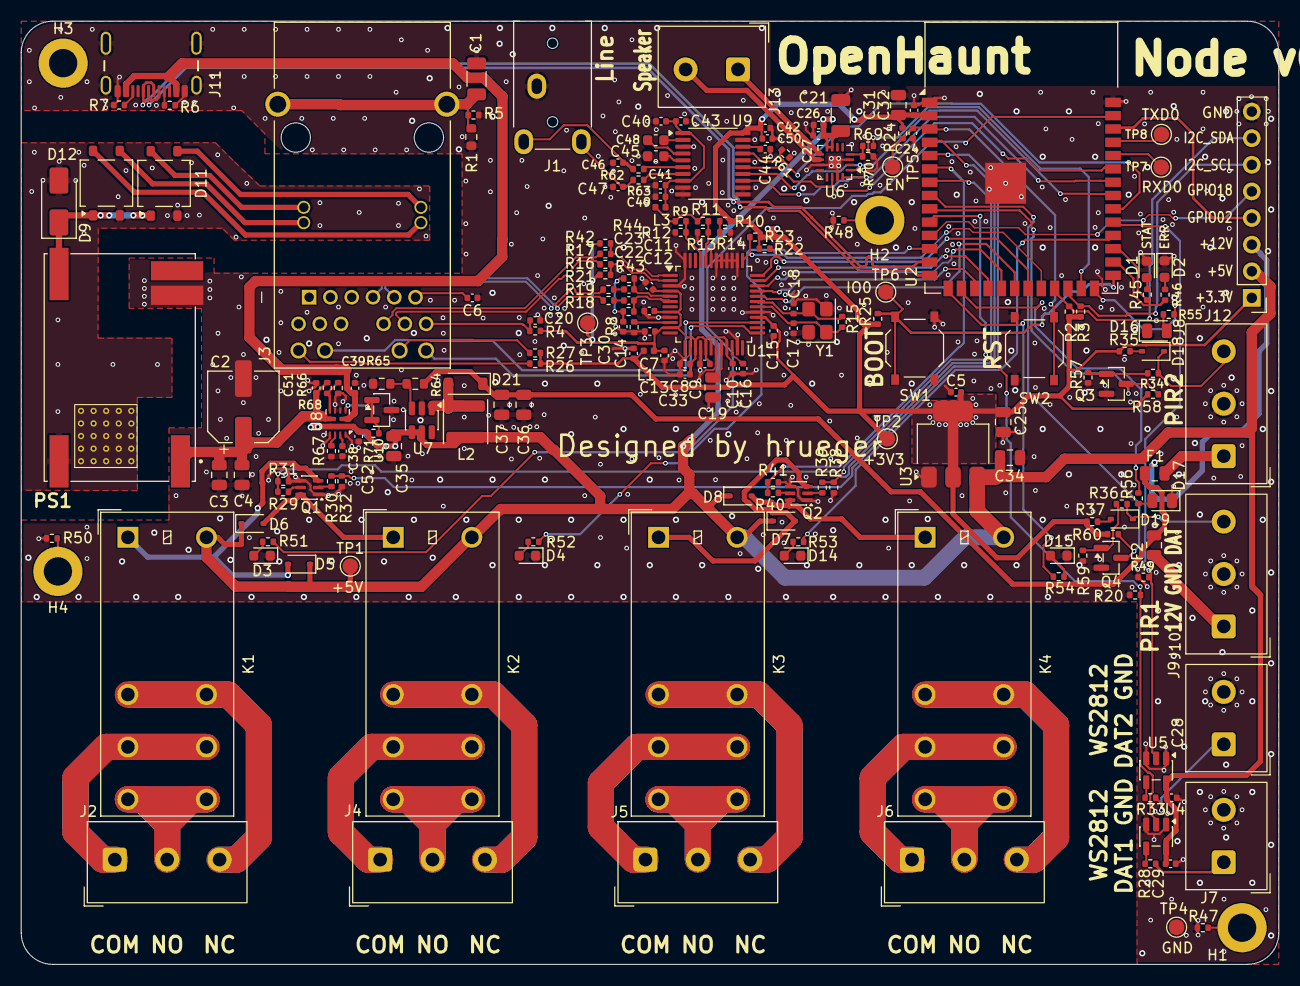
[picture p18: board OH_Node_V0_Prototype.kicad_pcb from above]

Board: 4 copper layers, 120.0 x 90.0 mm, 193 parts (0 on the bottom side), 139 nets.
