OpenHaunt/node/hardware/OH_Node_IO_LED8/OH_Node_IO_LED8.kicad_pcb

## KiCad design hardware/OH_Node_IO_LED8/OH_Node_IO_LED8.kicad_pcb (2026-09-09)

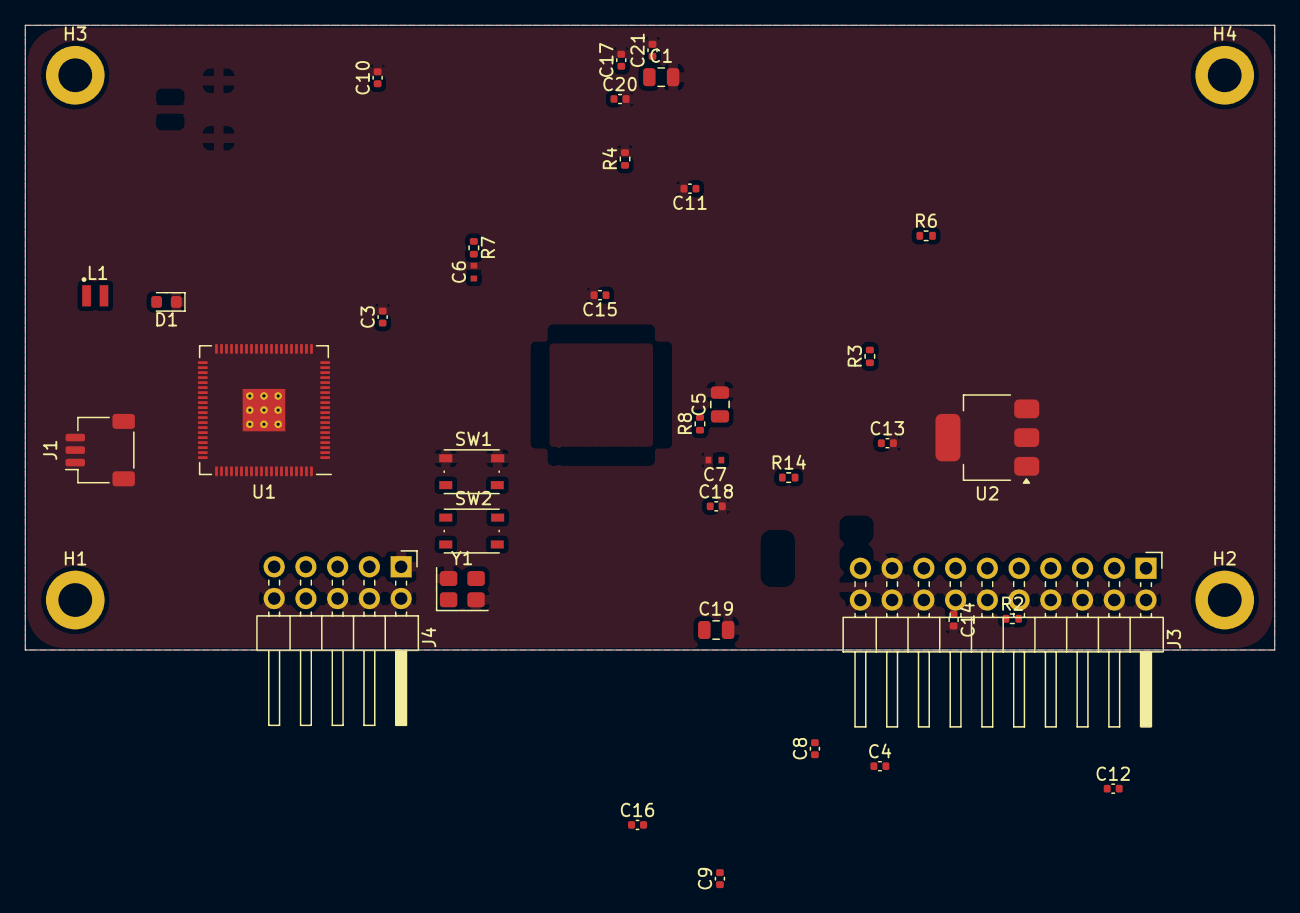
[picture p19: board OH_Node_IO_LED8.kicad_pcb from above]

Board: 4 copper layers, 100.0 x 50.0 mm, 41 parts (0 on the bottom side), 23 nets, no tracks yet.

Parts:
C1, C5: 22u; C_0805_2012Metric
C3, C4: 15p; C_0402_1005Metric
C6, C7: 4u7; C_0402_1005Metric_small_pads
C8, C11, C12, C13, C14, C15, C16, C17, C18, C20, C21: 100n; C_0402_1005Metric
C9, C10: 4u7; C_0402_1005Metric
C19: 10u; C_0805_2012Metric
D1: Blue Indicator LED; LED_0603_1608Metric
H1, H2, H3, H4: MountingHole; MountingHole_2.7mm_M2.5_DIN965_Pad
J1: SM03B-SRSS-TB; JST_SH_SM03B-SRSS-TB_1x03-1MP_P1.00mm_Horizontal
J3: 61302021021; PinHeader_2x10_P2.54mm_Horizontal
J4: 61301021021; PinHeader_2x05_P2.54mm_Horizontal
L1: 3u3; L_2016_pol
R2, R4, R6: 1K; R_0402_1005Metric
R3: 33; R_0402_1005Metric
R7, R8: 27; R_0402_1005Metric
R14: 110; R_0402_1005Metric
SW1, SW2: Push; SW_Push_1P1T_NO_Vertical_Wuerth_434133025816
U1: RP2354B; RP235XB
U2: AMS1117-3.3; SOT-223-3_TabPin2
Y1: ABM8-272-T3; Crystal_SMD_3225-4Pin_3.2x2.5mm

Connections:
+1V1: C7.1, C8.1, C10.1, C11.1, L1.1, U1.10 (DVDD), U1.32 (DVDD), U1.51 (DVDD), U1.65 (VREG_FB)
+3V3: C5.1, C6.1, C12.1, C13.1, C14.1, C15.1, C16.1, C17.1, C18.1, C19.1, C20.1, C21.1, J3.15, R3.1, U1.5 (IOVDD), U1.15 (IOVDD), U1.24 (IOVDD), U1.29 (IOVDD), U1.41 (IOVDD), U1.50 (IOVDD), U1.59 (ADC_AVDD), U1.60 (IOVDD), U1.64 (VREG_VIN), U1.68 (USB_OTP_VDD), U1.69 (QSPI_IOVDD), U1.76 (IOVDD), U2.2 (VO)
+5V: J3.7, J3.9, J3.11, J3.13
+12V: J3.3, J3.5
/IO_ATTN: J4.8, R6.2, SW1.2
/IO_BOOTSEL: J4.9, U1.48 (GPIO39)
/IO_nRESET: J4.7, SW2.2, U1.35 (RUN)
/RP2354B/QSPI_SS: R6.1, U1.75 (QSPI_SS)
/RP2354B/SWCLK: J1.1, U1.33 (SWCLK)
/RP2354B/SWD: J1.3, U1.34 (SWD)
/RP2354B/VREG_AVDD: C9.1, R3.2, U1.61 (VREG_AVDD)
/RP2354B/VREG_LX: L1.2, U1.63 (VREG_LX)
/RP2354B/XIN: C3.1, U1.30 (XIN), Y1.1
/RP2354B/XOUT: R2.1, U1.31 (XOUT)
/USB_D+: J4.5, R7.1
/USB_D-: J4.3, R8.1
GND: C1.2, C3.2, C4.2, C5.2, C6.2, C7.2, C8.2, C9.2, C10.2, C11.2, C12.2, C13.2, C14.2, C15.2, C16.2, C17.2, C18.2, C19.2, C20.2, C21.2, D1.1 (K), J1.2, J1.MP (MountPin), J3.2, J3.4, J3.6, J3.8, J3.10, J3.12, J3.14, J3.16, J3.17, J3.18, J3.19, J3.20, J4.1, J4.2, J4.4, J4.6, J4.10, R4.2, SW1.1, U1.62 (VREG_PGND), U1.81 (GND), U2.1 (GND), Y1.2, Y1.4
unnamed: C4.1, R2.2, Y1.3
unnamed: D1.2 (A), R14.2
unnamed: R4.1, SW2.1
unnamed: R8.2, U1.66 (USB_DM)
unnamed: R7.2, U1.67 (USB_DP)
VBUS: C1.1, U2.3 (VI)
