OpenHaunt/node/hardware/OH_Node_PWR_BT4/OH_Node_PWR_BT4.kicad_pcb

## KiCad design hardware/OH_Node_PWR_BT4/OH_Node_PWR_BT4.kicad_pcb (2026-09-09)

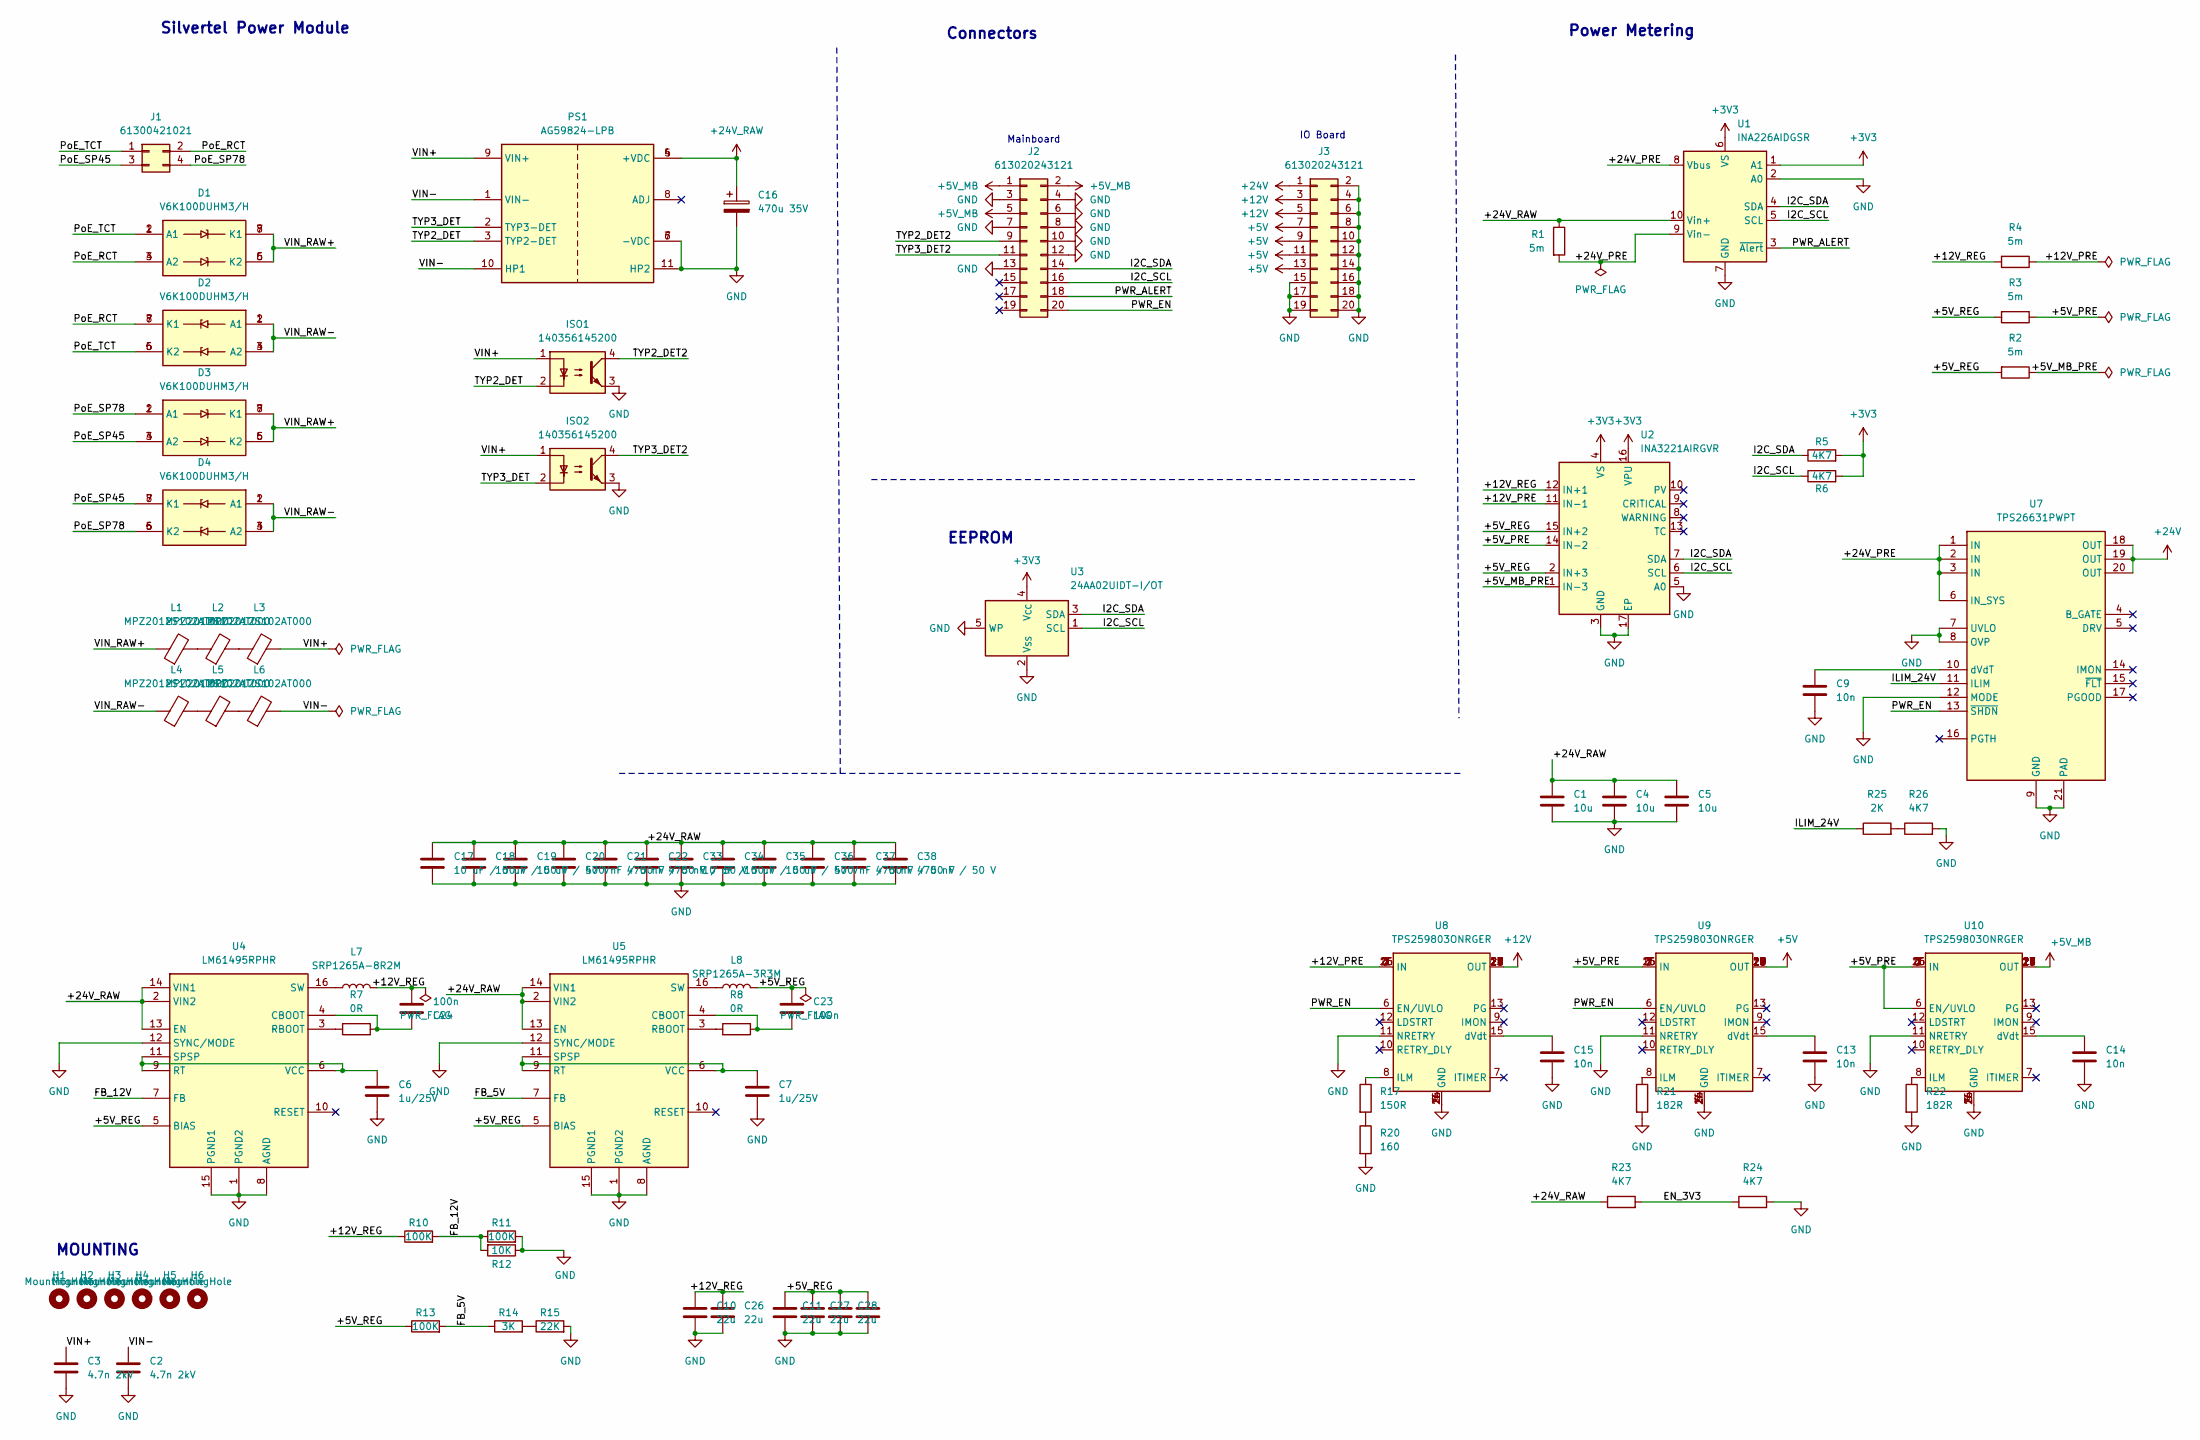
[picture p20: schematic OH_Node_PWR_BT4.kicad_sch]

Parts:
C1, C4, C5: 10u; C_0402_1005Metric; MPN GRM155R61A106ME11D
C2, C3: 4.7n 2kV; C_1812_4532Metric; MPN 885342211008
C6, C7: 1u/25V; C_0402_1005Metric; MPN CL05A105KA5NQNC
C9, C13, C14, C15: 10n; C_0402_1005Metric; MPN CL05B103KB5NNNC
C10, C11, C26, C27, C28, C29: 22u; C_1210_3225Metric; MPN GRM32ER71E226KE15L
C16: 470u 35V; CP_Elec_10x10.5; MPN EEH-ZU1V471P
C17, C18, C19, C33, C34, C35: 10 uF / 50 V; C_1210_3225Metric; MPN CC1210KKX7R9BB106
C20, C21, C22, C36, C37, C38: 470 nF / 50 V; C_0603_1608Metric; MPN C1608X7R1H474K080AC
C23, C24: 100n; C_0603_1608Metric; MPN CL10B104KB8NNNC
D1, D2, D3, D4: V6K100DUHM3/H; V6K100DUHM3H; Manufacturer_Part_Number V6K100DUHM3/H
H1, H2, H3, H4, H5, H6: MountingHole; MountingHole_2.7mm_M2.5_DIN965_Pad
ISO1, ISO2: 140356145200; WL-OCPT_SOP4; MPN 140356145200
J1: 61300421021; PinHeader_2x02_P2.54mm_Horizontal; MPN 61300421021
J2, J3: 613020243121; PinSocket_2x10_P2.54mm_Horizontal; MPN 613020243121
L1, L2, L3, L4, L5, L6: MPZ2012S102AT000; L_0805_2012Metric; MPN MPZ2012S102AT000
L7: SRP1265A-8R2M; Bourns_SRP1265A; MPN SRP1265A-8R2M
L8: SRP1265A-3R3M; Bourns_SRP1265A; MPN SRP1265A-3R3M
PS1: AG59824-LPB; AG59800-LPB; Manufacturer_Part_Number Ag5800
R1, R2, R3, R4: 5m; R_2512_6332Metric_Pad1.40x3.35mm_HandSolder; MPN PA2512FKM070R005E
R5, R6, R23, R24, R26: 4K7; R_0402_1005Metric; MPN RC0402JR-074K7L
R7, R8: 0R; R_0402_1005Metric; MPN RC0402JR-070RL
R10, R11, R13: 100K; R_0603_1608Metric; MPN RC0603JR-07100KL
R12: 10K; R_0402_1005Metric; MPN RC0402JR-0710KL
R14: 3K; R_0402_1005Metric; MPN RC0402JR-133KL
R15: 22K; R_0402_1005Metric; MPN RC0402JR-1322KL
R17: 150R; R_0402_1005Metric; MPN RC0402JR-07150RL
R20: 160; R_0402_1005Metric; MPN RC0402JR-07160RL
R21, R22: 182R; R_0402_1005Metric; MPN RC0402FR-07182RL
R25: 2K; R_0603_1608Metric; MPN RC0603FR-072KL
U1: INA226AIDGSR; MSOP-10_3x3mm_P0.5mm; MPN INA226AIDGSR
U2: INA3221AIRGVR; Texas_RGV0016A_VQFN-16-1EP_4x4mm_P0.65mm_EP2.1x2.1mm; MPN INA3221AIRGVR
U3: 24AA02UIDT-I/OT; SOT-23-5; MPN 24AA02UIDT-I/OT
U4, U5: LM61495RPHR; TI_LM61495RPHR; MPN LM61495RPHR
U7: TPS26631PWPT; HTSSOP-20-1EP_4.4x6.5mm_P0.65mm_EP2.74x3.86mm; MPN TPS26631PWPT
U8, U9, U10: TPS259803ONRGER; TI_TPS25980xx; MPN TPS259803ONRGER

Connections:
+3V3: R5.2, R6.2, U1.1 (A1), U1.6 (VS), U2.4 (VS), U2.16 (VPU), U3.4 (V_{CC})
+5V: J3.7, J3.9, J3.11, J3.13, U9.17 (OUT), U9.18 (OUT), U9.19 (OUT), U9.20 (OUT), U9.21 (OUT), U9.22 (OUT), U9.23 (OUT), U9.24 (OUT)
+5V_MB: J2.1, J2.2, J2.5, U10.17 (OUT), U10.18 (OUT), U10.19 (OUT), U10.20 (OUT), U10.21 (OUT), U10.22 (OUT), U10.23 (OUT), U10.24 (OUT)
+12V: J3.3, J3.5, U8.17 (OUT), U8.18 (OUT), U8.19 (OUT), U8.20 (OUT), U8.21 (OUT), U8.22 (OUT), U8.23 (OUT), U8.24 (OUT)
+24V: J3.1, U7.18 (OUT), U7.19 (OUT), U7.20 (OUT)
+24V_RAW: C1.1, C4.1, C5.1, C16.1, C17.1, C18.1, C19.1, C20.1, C21.1, C22.1, C33.1, C34.1, C35.1, C36.1, C37.1, C38.1, PS1.4 (+VDC), PS1.5 (+VDC), R1.1, R23.1, U1.10 (Vin+), U4.2 (VIN2), U4.13 (EN), U4.14 (VIN1), U5.2 (VIN2), U5.13 (EN), U5.14 (VIN1)
/+5V_MB_PRE: R2.1, U2.1 (IN-3)
/+5V_PRE: R3.1, U2.14 (IN-2), U9.1 (IN), U9.2 (IN), U9.3 (IN), U9.16 (IN), U9.25 (IN), U10.1 (IN), U10.2 (IN), U10.3 (IN), U10.6 (EN/UVLO), U10.16 (IN), U10.25 (IN)
/+5V_REG: C11.1, C23.1, C27.1, C28.1, C29.1, L8.2, R2.2, R3.2, R13.1, U2.2 (IN+3), U2.15 (IN+2), U4.5 (BIAS), U5.5 (BIAS)
/+12V_PRE: R4.1, U2.11 (IN-1), U8.1 (IN), U8.2 (IN), U8.3 (IN), U8.16 (IN), U8.25 (IN)
/+12V_REG: C10.1, C24.2, C26.1, L7.2, R4.2, R10.1, U2.12 (IN+1)
/+24V_PRE: R1.2, U1.8 (Vbus), U1.9 (Vin-), U7.1 (IN), U7.2 (IN), U7.3 (IN), U7.6 (IN_SYS)
/EN_3V3: R23.2, R24.1
/FB_5V: R13.2, R14.1, U5.7 (FB)
/FB_12V: R10.2, R11.1, R12.2, U4.7 (FB)
/I2C_SCL: J2.16, R6.1, U1.5 (SCL), U2.6 (SCL), U3.1 (SCL)
/I2C_SDA: J2.14, R5.1, U1.4 (SDA), U2.7 (SDA), U3.3 (SDA)
/ILIM_24V: R25.1, U7.11 (ILIM)
/PWR_ALERT: J2.18, U1.3 (~Alert)
/PWR_EN: J2.20, U7.13 (~SHDN), U8.6 (EN/UVLO), U9.6 (EN/UVLO)
/PoE_RCT: D1.3 (A2), D1.4 (A2), D2.7 (K1), D2.8 (K1), J1.2
/PoE_SP45: D3.3 (A2), D3.4 (A2), D4.7 (K1), D4.8 (K1), J1.3
/PoE_SP78: D3.1 (A1), D3.2 (A1), D4.5 (K2), D4.6 (K2), J1.4
/PoE_TCT: D1.1 (A1), D1.2 (A1), D2.5 (K2), D2.6 (K2), J1.1
/TYP2_DET: ISO1.2, PS1.3 (TYP2-DET)
/TYP2_DET2: ISO1.4, J2.9
/TYP3_DET: ISO2.2, PS1.2 (TYP3-DET)
/TYP3_DET2: ISO2.4, J2.11
/VIN+: C3.1, ISO1.1, ISO2.1, L3.2, PS1.9 (VIN+)
/VIN-: C2.1, L6.2, PS1.1 (VIN-), PS1.10 (HP1)
/VIN_RAW+: D1.5 (K2), D1.6 (K2), D1.7 (K1), D1.8 (K1), D3.5 (K2), D3.6 (K2), D3.7 (K1), D3.8 (K1), L1.1
/VIN_RAW-: D2.1 (A1), D2.2 (A1), D2.3 (A2), D2.4 (A2), D4.1 (A1), D4.2 (A1), D4.3 (A2), D4.4 (A2), L4.1
GND: C1.2, C2.2, C3.2, C4.2, C5.2, C6.2, C7.2, C9.2, C10.2, C11.2, C13.2, C14.2, C15.2, C16.2, C17.2, C18.2, C19.2, C20.2, C21.2, C22.2, C26.2, C27.2, C28.2, C29.2, C33.2, C34.2, C35.2, C36.2, C37.2, C38.2, ISO1.3, ISO2.3, J2.3, J2.4, J2.6, J2.7, J2.8, J2.10, J2.12, J2.13, J3.2, J3.4, J3.6, J3.8, J3.10, J3.12, J3.14, J3.15, J3.16, J3.17, J3.18, J3.19, J3.20, PS1.6 (-VDC), PS1.7 (-VDC), PS1.11 (HP2), R11.2, R12.1, R15.2, R20.2, R21.2, R22.2, R24.2, R26.2, U1.2 (A0), U1.7 (GND), U2.3 (GND), U2.5 (A0), U2.17 (EP), U3.2 (V_{SS}), U3.5 (WP), U4.1 (PGND2), U4.8 (AGND), U4.12 (SYNC/MODE), U4.15 (PGND1), U5.1 (PGND2), U5.8 (AGND), U5.12 (SYNC/MODE), U5.15 (PGND1), U7.7 (UVLO), U7.8 (OVP), U7.9 (GND), U7.12 (MODE), U7.21 (PAD), U8.4 (GND), U8.5 (GND), U8.11 (NRETRY), U8.14 (GND), U8.26 (GND), U9.4 (GND), U9.5 (GND), U9.11 (NRETRY), U9.14 (GND), U9.26 (GND), U10.4 (GND), U10.5 (GND), U10.11 (NRETRY), U10.14 (GND), U10.26 (GND)
unnamed: L1.2, L2.1
unnamed: L2.2, L3.1
unnamed: L4.2, L5.1
unnamed: L5.2, L6.1
unnamed: R14.2, R15.1
unnamed: R17.2, R20.1
unnamed: R25.2, R26.1
unnamed: C24.1, R7.2, U4.4 (CBOOT)
unnamed: R7.1, U4.3 (RBOOT)
unnamed: C6.1, U4.6 (VCC), U4.9 (RT), U4.11 (SPSP)
unnamed: L7.1, U4.16 (SW)
unnamed: C23.2, R8.1, U5.4 (CBOOT)
unnamed: R8.2, U5.3 (RBOOT)
unnamed: C7.1, U5.6 (VCC), U5.9 (RT), U5.11 (SPSP)
unnamed: L8.1, U5.16 (SW)
unnamed: C9.1, U7.10 (dVdT)
unnamed: R17.1, U8.8 (ILM)
unnamed: C15.1, U8.15 (dVdt)
unnamed: R21.1, U9.8 (ILM)
unnamed: C13.1, U9.15 (dVdt)
unnamed: R22.1, U10.8 (ILM)
unnamed: C14.1, U10.15 (dVdt)

Notes on the sheet:
Silvertel Power Module
Power Metering
Connectors
EEPROM
Mainboard
IO Board
MOUNTING

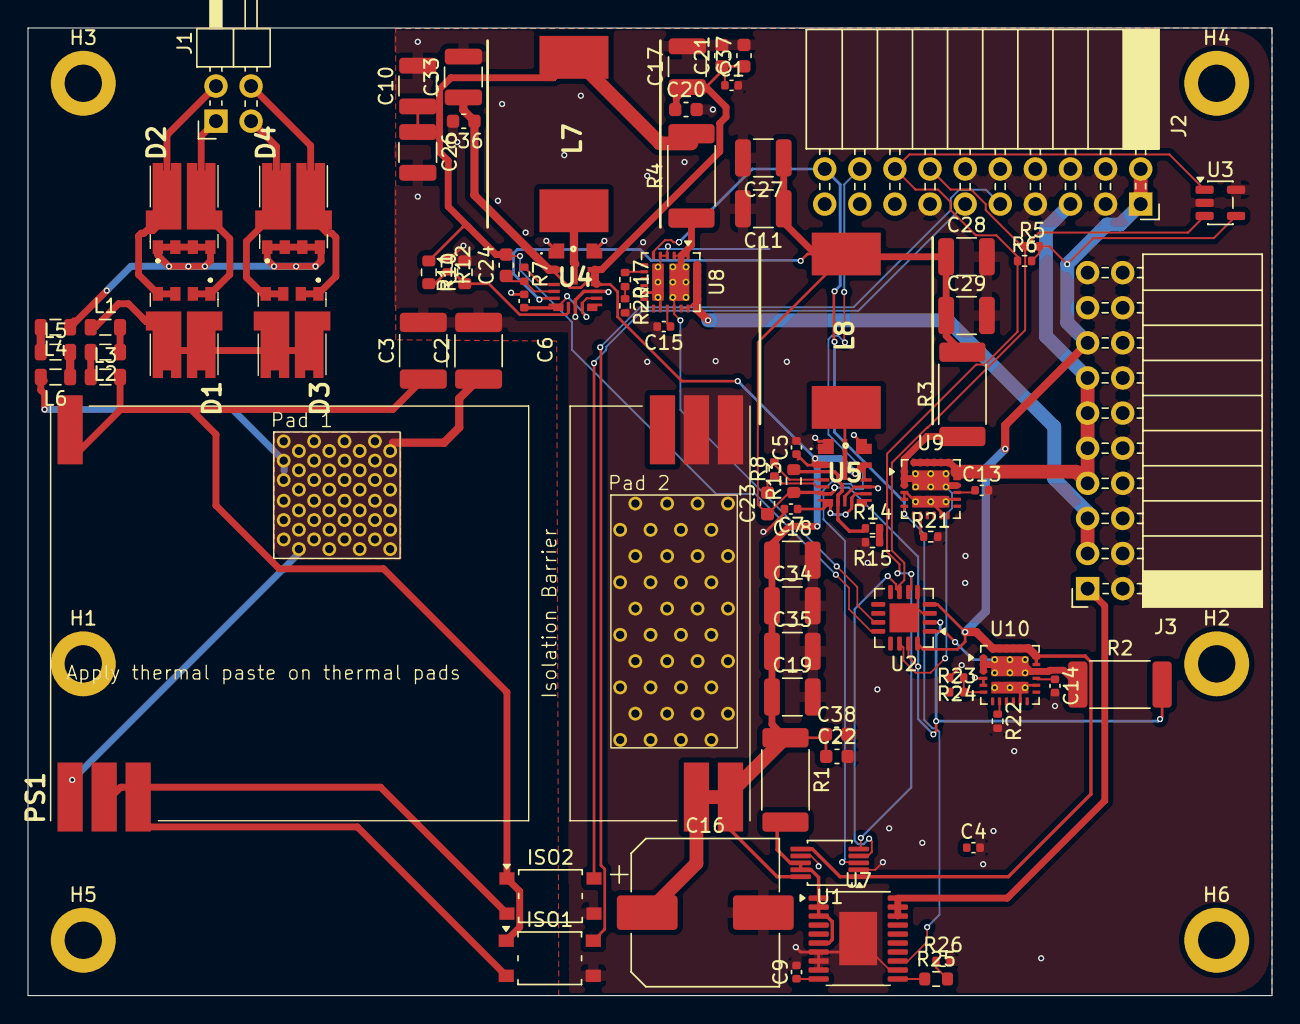
[picture p21: board OH_Node_PWR_BT4.kicad_pcb from above]

Board: 4 copper layers, 90.0 x 70.0 mm, 87 parts (0 on the bottom side), 55 nets.
