OpenHaunt/node/hardware/OH_Node_Mainboard/OH_Node_Mainboard.kicad_pcb

## KiCad design hardware/OH_Node_Mainboard/OH_Node_Mainboard.kicad_pcb (2026-09-09)

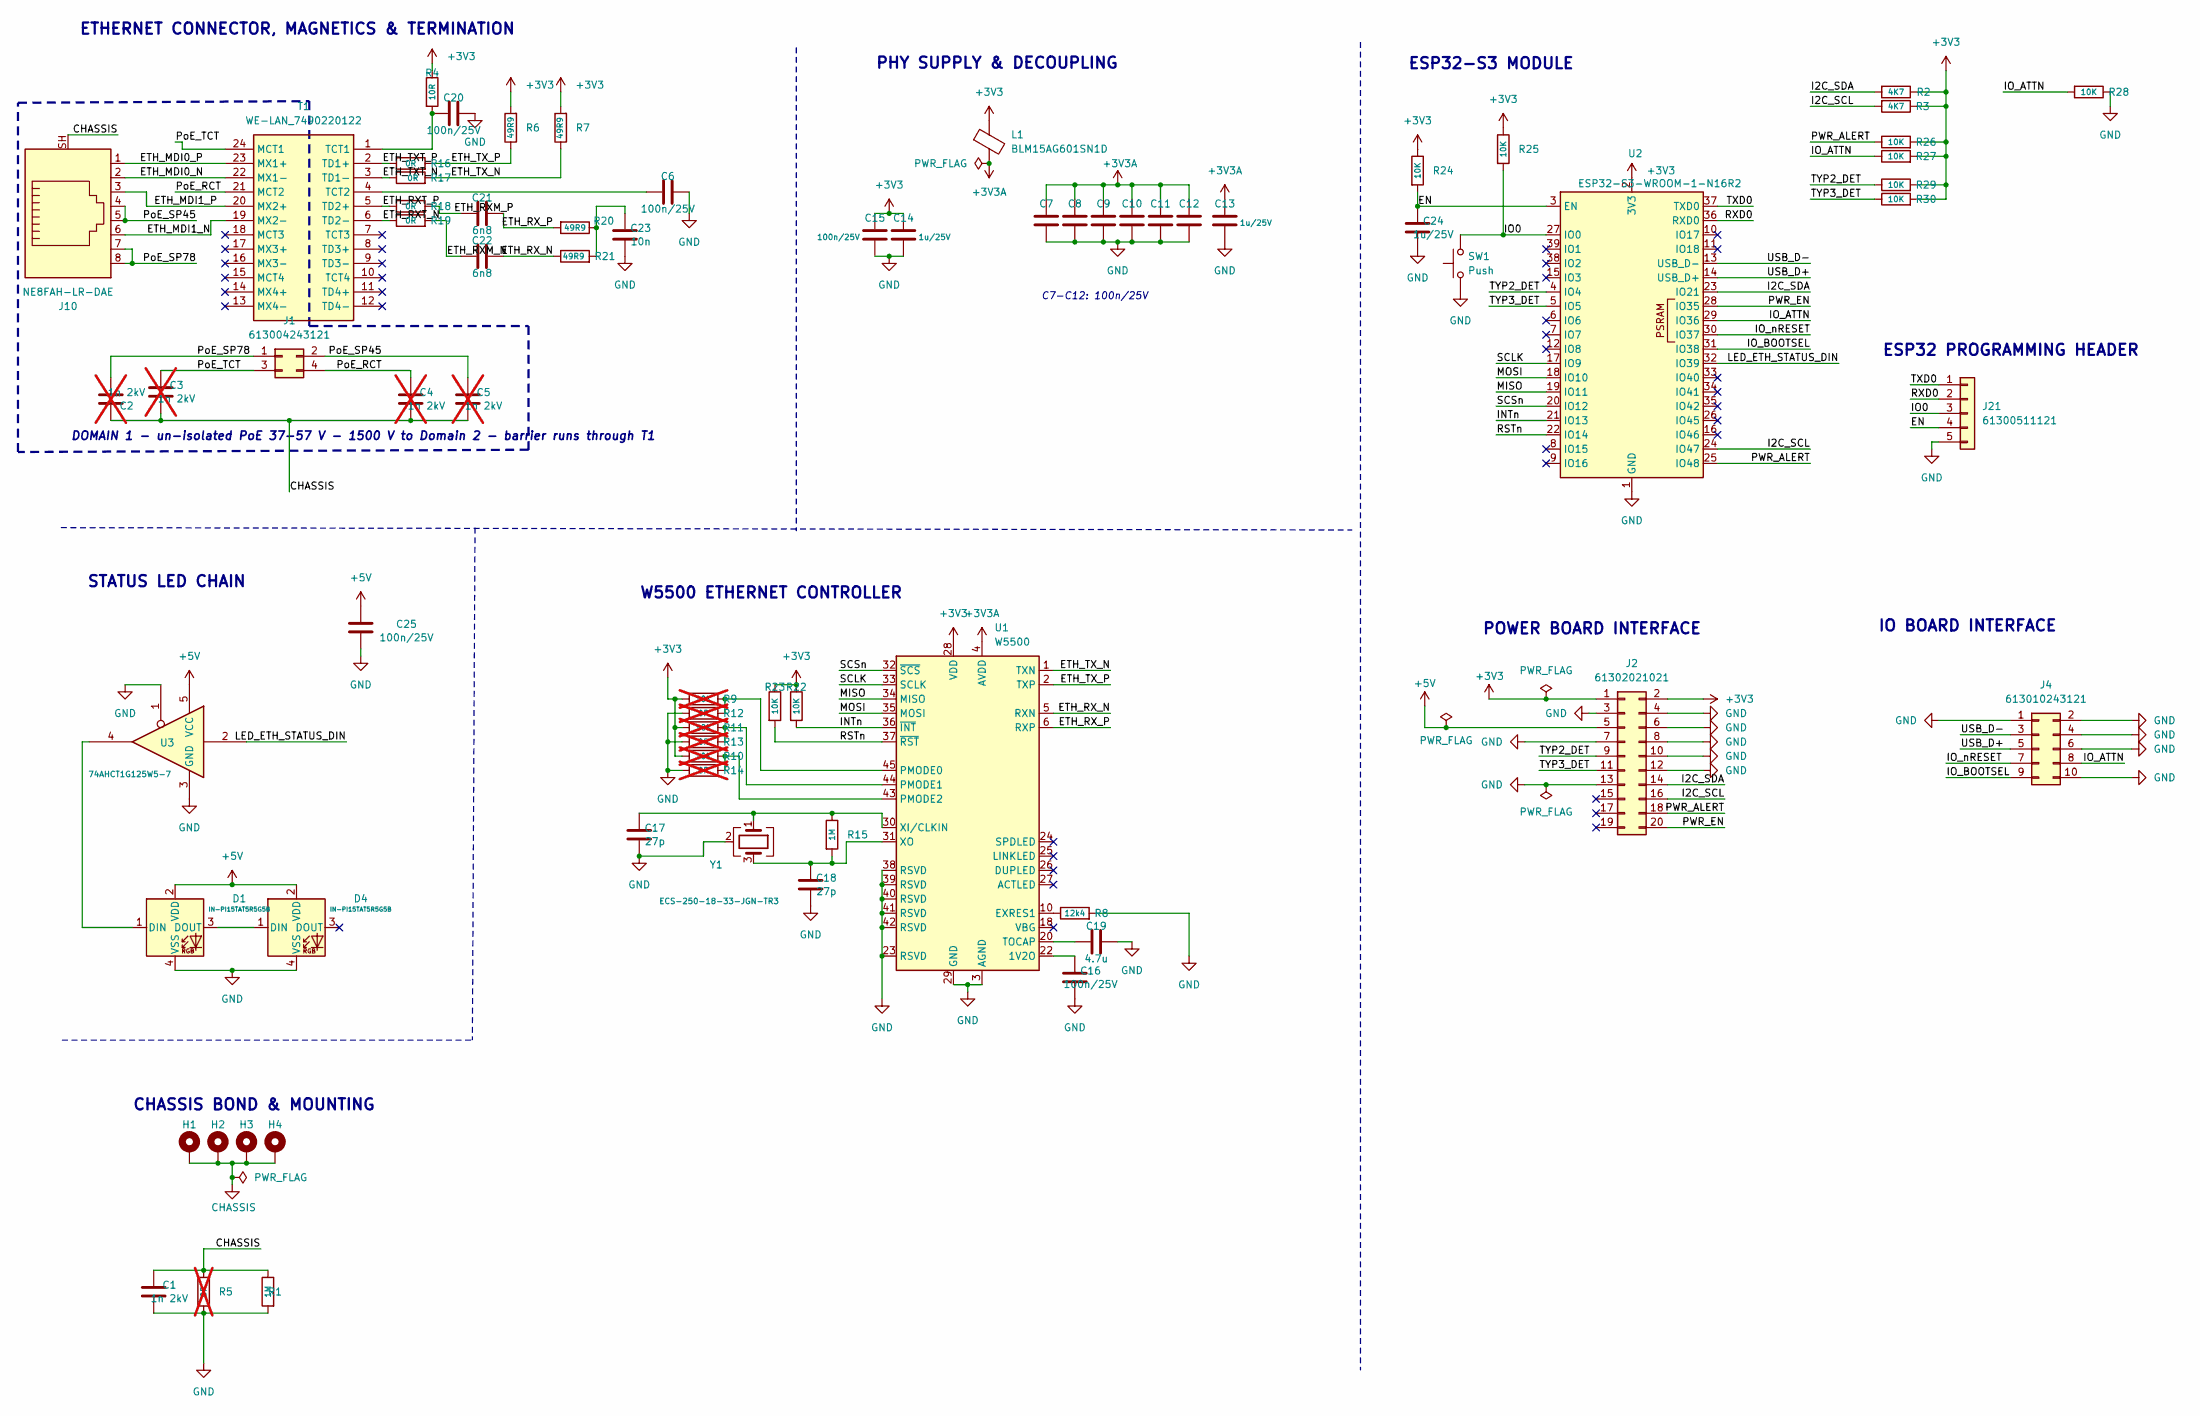
[picture p22: schematic OH_Node_Mainboard.kicad_sch]

Parts:
C1: 1n 2kV; C_1206_3216Metric; MPN 885342208024
C2, C3, C4, C5: 1n 2kV; C_1206_3216Metric; MPN 885342208024; not fitted
C6, C7, C8, C9, C10, C11, C12, C15, C16, C20, C25: 100n/25V; C_0402_1005Metric; MPN CL05A104KA5NNNC
C13, C14, C24: 1u/25V; C_0402_1005Metric; MPN CL05A105KA5NQNC
C17, C18: 27p; C_0402_1005Metric; MPN GRM1555C1H270JA01D
C19: 4.7u; C_0402_1005Metric; MPN CL21A475KLCLQNC
C21, C22: 6n8; C_0402_1005Metric; MPN CL05B682KB5NNNC
C23: 10n; C_0402_1005Metric; MPN CL05B103KB5NNNC
D1, D4: IN-PI15TAT5R5G5B; Inolux_IN-PI15TAT5R5G5B; MPN IN-PI15TAT5R5G5B
H1, H2, H3, H4: MountingHole_Pad; MountingHole_2.7mm_M2.5_DIN965_Pad
J1: 613004243121; PinSocket_2x02_P2.54mm_Horizontal; MPN 613004243121
J2: 61302021021; PinHeader_2x10_P2.54mm_Horizontal; MPN 61302021021
J4: 613010243121; PinSocket_2x05_P2.54mm_Horizontal; MPN 613010243121
J10: NE8FAH-LR-DAE; Neutrik_NE8FAH-LR-DAE; MPN NE8FAH-LR-DAE
J21: 61300511121; PinHeader_1x05_P2.54mm_Vertical; MPN 61300511121
L1: BLM15AG601SN1D; L_0402_1005Metric; MPN BLM15AG601SN1D
R1: 1M; R_0603_1608Metric; MPN RC0603JR-071ML
R2, R3: 4K7; R_0402_1005Metric; MPN RC0402JR-074K7L
R4: 10R; R_0402_1005Metric; MPN SR0402KR-0710RL
R5, R12, R13, R14: 0R; R_0402_1005Metric; MPN RC0402JR-070RL; not fitted
R6, R7, R20, R21: 49R9; R_0402_1005Metric; MPN RC0402FR-0749R9L
R8: 12k4; R_0402_1005Metric; MPN RC0402FR-0712K4L
R9, R10, R11: 10K; R_0402_1005Metric; MPN RC0402JR-0710KL; not fitted
R15: 1M; R_0402_1005Metric; MPN RC0402JR-071ML
R16, R17, R18, R19: 0R; R_0402_1005Metric; MPN RC0402JR-070RL
R22, R23, R24, R25, R26, R27, R28, R29, R30: 10K; R_0402_1005Metric; MPN RC0402JR-0710KL
SW1: Push; SW_Push_1P1T_NO_Vertical_Wuerth_434133025816; MPN 434133025816
T1: WE-LAN_7490220122; Manufacturer_Part_Number 7490220122
U1: W5500; LQFP-48_7x7mm_P0.5mm; MPN W5500
U2: ESP32-S3-WROOM-1-N16R2; Espressif_ESP32-S3-WROOM-1; MPN ESP32-S3-WROOM-1-N16R2
U3: 74AHCT1G125W5-7; SOT-353_SC-70-5; MPN 74AHCT1G125W5-7
Y1: ECS-250-18-33-JGN-TR3; Crystal_SMD_3225-4Pin_3.2x2.5mm; MPN ECS-250-18-33-JGN-TR3

Connections:
+3V3: C14.1, C15.1, J2.1, J2.2, L1.1, R2.1, R3.1, R4.1, R6.2, R7.2, R9.1, R10.1, R11.1, R22.1, R23.1, R24.1, R25.1, R26.2, R27.2, R29.2, R30.2, U1.28 (VDD), U2.2 (3V3)
+3V3A: C7.1, C8.1, C9.1, C10.1, C11.1, C12.1, C13.1, L1.2, U1.4 (AVDD), U1.8 (AVDD), U1.11 (AVDD), U1.15 (AVDD), U1.17 (AVDD), U1.21 (AVDD)
+5V: C25.1, D1.2 (VDD), D4.2 (VDD), J2.5, U3.5 (VCC)
/EN: C24.1, J21.4, R24.2, U2.3 (EN)
/ETH_MDI0_N: J10.2, T1.22 (MX1-)
/ETH_MDI0_P: J10.1, T1.23 (MX1+)
/ETH_MDI1_N: J10.6, T1.19 (MX2-)
/ETH_MDI1_P: J10.3, T1.20 (MX2+)
/ETH_RXM_N: C22.1, R19.2
/ETH_RXM_P: C21.1, R18.2
/ETH_RXT_N: R19.1, T1.6 (TD2-)
/ETH_RXT_P: R18.1, T1.5 (TD2+)
/ETH_RX_N: C22.2, R21.1, U1.5 (RXN)
/ETH_RX_P: C21.2, R20.2, U1.6 (RXP)
/ETH_TXT_N: R17.1, T1.3 (TD1-)
/ETH_TXT_P: R16.1, T1.2 (TD1+)
/ETH_TX_N: R7.1, R17.2, U1.1 (TXN)
/ETH_TX_P: R6.1, R16.2, U1.2 (TXP)
/I2C_SCL: J2.16, R3.2, U2.24 (IO47)
/I2C_SDA: J2.14, R2.2, U2.23 (IO21)
/INTn: R22.2, U1.36 (~INT), U2.21 (IO13)
/IO0: J21.3, R25.2, SW1.2, U2.27 (IO0)
/IO_ATTN: J4.8, R27.1, R28.2, U2.29 (IO36)
/IO_BOOTSEL: J4.9, U2.31 (IO38)
/IO_nRESET: J4.7, U2.30 (IO37)
/LED_ETH_STATUS_DIN: U2.32 (IO39), U3.2
/MISO: U1.34 (MISO), U2.19 (IO11)
/MOSI: U1.35 (MOSI), U2.18 (IO10)
/PWR_ALERT: J2.18, R26.1, U2.25 (IO48)
/PWR_EN: J2.20, U2.28 (IO35)
/PoE_RCT: C4.2, J1.4, T1.21 (MCT2)
/PoE_SP45: C5.2, J1.2, J10.4, J10.5
/PoE_SP78: C2.1, J1.1, J10.7, J10.8
/PoE_TCT: C3.2, J1.3, T1.24 (MCT1)
/RSTn: R23.2, U1.37 (~RST), U2.22 (IO14)
/RXD0: J21.2, U2.36 (RXD0)
/SCLK: U1.33 (SCLK), U2.17 (IO9)
/SCSn: U1.32 (~SCS), U2.20 (IO12)
/TXD0: J21.1, U2.37 (TXD0)
/TYP2_DET: J2.9, R29.1, U2.4 (IO4)
/TYP3_DET: J2.11, R30.1, U2.5 (IO5)
/USB_D+: J4.5, U2.14 (USB_D+)
/USB_D-: J4.3, U2.13 (USB_D-)
CHASSIS: C1.1, C2.2, C3.1, C4.1, C5.1, H1.1 (1_1), H2.1 (1_1), H3.1 (1_1), H4.1 (1_1), J10.SH, R1.1, R5.1
GND: C1.2, C6.2, C7.2, C8.2, C9.2, C10.2, C11.2, C12.2, C13.2, C14.2, C15.2, C16.2, C17.2, C18.2, C19.2, C20.2, C23.2, C24.2, C25.2, D1.4 (VSS), D4.4 (VSS), J2.3, J2.4, J2.6, J2.7, J2.8, J2.10, J2.12, J2.13, J4.1, J4.2, J4.4, J4.6, J4.10, J21.5, R1.2, R5.2, R8.2, R12.1, R13.1, R14.1, R28.1, SW1.1, U1.3 (AGND), U1.9 (AGND), U1.14 (AGND), U1.16 (AGND), U1.19 (AGND), U1.23 (RSVD), U1.29 (GND), U1.38 (RSVD), U1.39 (RSVD), U1.40 (RSVD), U1.41 (RSVD), U1.42 (RSVD), U1.48 (AGND), U2.1 (GND), U2.40 (GND), U2.41 (GND), U3.1, U3.3 (GND), Y1.2 (G), Y1.4 (G)
unnamed: C23.1, R20.1, R21.2
unnamed: D1.1 (DIN), U3.4
unnamed: D1.3 (DOUT), D4.1 (DIN)
unnamed: C20.1, R4.2, T1.1 (TCT1)
unnamed: C6.1, T1.4 (TCT2)
unnamed: C16.1, U1.22 (1V2O)
unnamed: R8.1, U1.10 (EXRES1)
unnamed: R9.2, R12.2, U1.45 (PMODE0)
unnamed: R11.2, R13.2, U1.44 (PMODE1)
unnamed: R10.2, R14.2, U1.43 (PMODE2)
unnamed: C19.1, U1.20 (TOCAP)
unnamed: C17.1, R15.1, U1.30 (XI/CLKIN), Y1.1
unnamed: C18.1, R15.2, U1.31 (XO), Y1.3

Notes on the sheet:
C7-C12: 100n/25V
IO BOARD INTERFACE
ETHERNET CONNECTOR, MAGNETICS & TERMINATION
ESP32 PROGRAMMING HEADER
POWER BOARD INTERFACE
ESP32-S3 MODULE
PHY SUPPLY & DECOUPLING
W5500 ETHERNET CONTROLLER
DOMAIN 1 - un-isolated PoE 37-57 V - 1500 V to Domain 2 - barrier runs through T1
CHASSIS BOND & MOUNTING
STATUS LED CHAIN

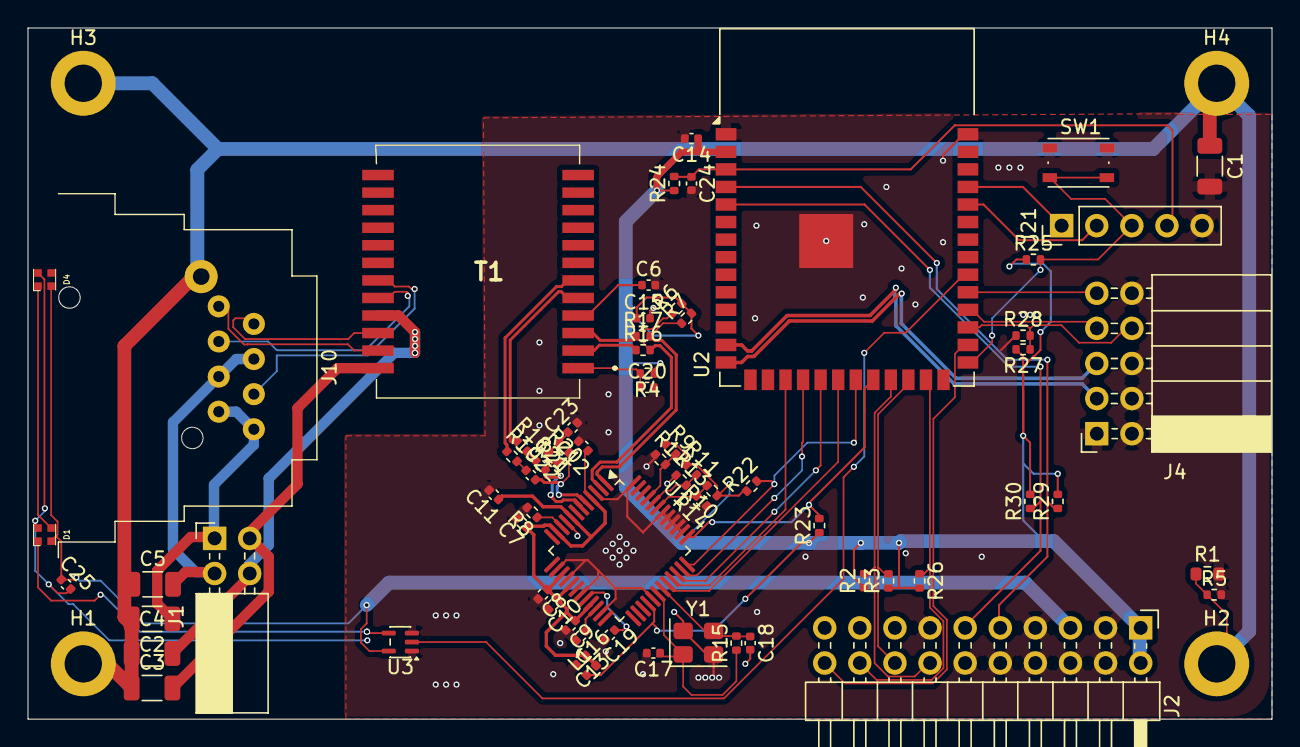
[picture p23: board OH_Node_Mainboard.kicad_pcb from above]

Board: 4 copper layers, 90.0 x 50.0 mm, 73 parts (0 on the bottom side), 58 nets.
