OpenHaunt/node/(commit log)

2026-08-12 Capture OpenHaunt Node concept and component selection
    Documents the design of a PoE-powered, modular, network-discoverable I/O
    node for scare mazes, haunted attractions and escape rooms.
    Architecture: one base board (PoE, Ethernet, ESP32, storage, module
    connector) plus a family of plug-on sensor and actuator modules. The base
    board stays SELV in all configurations; any hazardous-voltage isolation
    lives on the module.
    Component selection is complete and justified, the pin budget is verified
    to close with one spare, and open questions are recorded explicitly so the
    project can be resumed without re-deriving any of it.
2026-08-29 Scaffold: one ESP-IDF tree for three boards, pure-C protocol core with host tests
    - oh_core: port/module model, EEPROM descriptor + CRC-16/CCITT-FALSE, every
    wire shape from OpenHaunt/node doc 06 (info/state/payloads/input/health),
    virtual-module JSON in the node-sim's NodeConfig shape plus bindings,
    catalogue presets, first-edge-preserving debounce, E1.31 parser
    - oh_board: Kconfig board choice and pin table for oh-base, ESP32-C6-DevKitC-1,
    ESP32-1732S019
    - boards/*/sdkconfig.board + partitions per flash size, scripts/build.sh
    - test/host: Unity + ctest on macOS using IDF's vendored cJSON/Unity
    [esp32c6-8mb.csv, esp32s3-16mb.csv, oh-base-4mb.csv]
2026-08-29 Phase 1: Wi-Fi with setup-AP fallback, mDNS, HTTP API, web UI, GPIO drivers, console
    - oh_node: state store, driver registry/vtable, module bind, esp_event fan-out,
    health error codes; oh_clock: unix ms once SNTP synced, boot ms before
    - oh_drivers: gpio_in (any-edge ISR, first-edge timestamps, shared debounce
    task) and gpio_out
    - oh_config: NVS-backed name/broker/dmx/wifi/network with validate-then-apply
    partial merge; virtual module blob
    - oh_net: STA with backoff, captive-portal setup AP after a timeout or when
    there are no credentials, mDNS _openhaunt._tcp with the doc-06 TXT record,
    SNTP with DHCP option 42, RMII/RTL8201 init for the base board
    - oh_http: /api/v1 info/state/co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
    [gpio_in.c, gpio_out.c, oh-serial.py, oh_app.c, oh_app.h, oh_captive_dns.c]
2026-08-29 MQTT client and ST7789 status display
    - oh_mqtt: esp-mqtt with the doc-06 topics: retained status with an offline
    will, output/+/set subscription applied by the port's dataType, input events
    with the node timestamp (queued while the broker is unreachable), health
    every 10 s with the chip temperature where the SoC has a sensor. Re-sending
    the same broker is a no-op, so a controller's re-POST on every resolve does
    not flap the session.
    - oh_display: esp_lcd ST7789 over SPI (i80 behind Kconfig), RGB565 framebuffer
    in PSRAM, Spleen 8x16 font (BSD-2), one status screen with live port
    values; identify flips the inversion at 4 Hz; rotation persisted in NVS and
    settable with `oh disp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
    [oh_display.c, oh_display.h, oh_fb.c, oh_fb.h]
2026-08-29 Phase 3 drivers: ws2812, mcp23017 in/out, sht4x, ssd1306, shared I2C bus
    - oh_i2c: one master bus from the board pins, shared by drivers and (later)
    the ID EEPROM
    - ws2812 via led_strip/RMT: colour x intensity on every pixel
    - mcp23017_in: MOD_INT edge -> ISR timestamp -> INTCAP/GPIO read, plus a 500 ms
    safety poll; mcp23017_out drives OLAT
    - sht4x: polled with hysteresis and a 30 s heartbeat; ports matched by unit/class
    - ssd1306 via esp_lcd I2C: one string port, lines split on newline
    - oh_font: Spleen 8x16 (BSD-2) shared by the display and the OLED
2026-08-29 OTA, module ID EEPROM, test tooling; verified against the-pult over the LAN
    - oh_ota: POST /api/v1/ota streams a raw image into the other slot with the
    bootloader's rollback; the image is confirmed once the network is up (or
    with `oh ota confirm`). Garbage is rejected before anything is written.
    - oh_module_eeprom: 24AA02UID descriptor read/write, catalogue table binding
    the real module drivers, power-budget check, MOD_nRESET held through boot
    and released after bind. `oh eeprom read|write` programs a module.
    - version.txt is now a configure dependency, so a bump reaches esp_app_desc.
    - scripts: mqtt-sub.py (dependency-free MQTT subscriber), pult-call.mjs
    (the-pult WebSocket calls: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
    [mqtt-sub.py, oh_app.c, oh_module_eeprom.c, oh_module_eeprom.h]
2026-08-29 sACN receiver, DMX UART gateway driver, Ethernet-to-Wi-Fi fallback, README
    - oh_sacn: UDP 5568, unicast plus the universe's multicast group, opened only
    while the bound module describes dmx and a controller has set a universe;
    frames for other universes are dropped. Verified: the-pult adopts the dmx
    preset, allocates universe 1, pushes dmx config, the node listens; synthetic
    unicast E1.31 frames are counted and other universes ignored.
    - dmx_uart: 250 kbaud 8N2 with a break before every frame at a steady refresh,
    RS485 half-duplex so RTS is the transceiver's DE; bound for 0x0001 from the
    EEPROM table and the dmx preset where the board has a module UART.
    - oh-base: Wi-Fi (station,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
2026-08-29 Show percent ports as percent and colours as a swatch
    A `percent` port declared over 0..1 — the catalogue's intensity — carries a
    fraction, so 1.0 was printed as "1.00%". The display and the web UI now show
    it as 100%, a port declared over 0..100 as it is, and temperatures with their
    unit. Colour ports get a swatch beside the value on both.
2026-08-30 Pure-C core for effects, transitions and the console clock
    A node that can trace a shape for itself is handed one description and then left
    alone: a three second fade was a hundred and twenty MQTT publishes and is now
    one, and a chase never stopped producing them at all. This is the arithmetic
    that makes that possible, with no ESP-IDF dependency and no globals, so it is all
    covered by the host tests.
    `oh_curve.c` is the third implementation of the five shapes and five easings.
    `pult-backend` and `openhaunt-node-sim` have the others, none of the three shares
    code, and all three test suites assert the same numeric table. Three
    implementations agreeing because they were each written from the p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
2026-08-30 Render shapes and timed fades on the node itself
    Verified on the ESP32-1732S019: a 0.5 Hz sine from a running the-pult is one
    MQTT message and then twelve seconds of silence, while the port moves on its own.
    At 40 Hz that window used to be 480 messages. A three second ease-in-out fade
    arrives as one timed `set` and the node walks it: 0.003, 0.10, 0.33, 0.66, 0.90,
    1.0.
    `render_task` runs at 40 Hz on priority 6 — above MQTT and the sensors, below the
    DMX UART, because a missed frame is visible and a late breath is not. It writes
    through `write_locked`, factored out of `oh_node_set_output`, which deliberately
    posts no event: forty events a second per port would flood the loop and redraw the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
    [mqtt-sub.py, oh_json.c]
2026-09-07 wip: mainboard schematic in kicad 11
    [OH_Node_Mainboard.kicad_pcb, OH_Node_Mainboard.kicad_sch]
2026-09-07 chore: downgrade to kicad 10
    [OH_Node_Mainboard.kicad_pcb, OH_Node_Mainboard.kicad_sch]
2026-09-08 wip: routing
    [OH_Node_Mainboard.kicad_pcb, OH_Node_Mainboard.kicad_sch]
2026-09-08 wip: pwr bt4
    [OH_Node_Mainboard.kicad_pcb, OH_Node_PWR_BT4.kicad_pcb, OH_Node_PWR_BT4.kicad_sch]
2026-09-09 wip: remove 3.3V from poe board, add led8 io board
    [OH_Node_IO_LED8.kicad_pcb, OH_Node_IO_LED8.kicad_sch, OH_Node_Mainboard.kicad_pcb, OH_Node_PWR_BT4.kicad_pcb, OH_Node_PWR_BT4.kicad_sch, RP2354B.kicad_sch]
2026-09-10 feat: v0 prototype board
    [OH_Node_V0_Prototype.kicad_pcb, OH_Node_V0_Prototype.kicad_sch]
2026-09-29 wip: C19 TOCAP cap to 0805 footprint
    [OH_Node_V0_Prototype.kicad_pcb, OH_Node_V0_Prototype.kicad_sch]
2026-10-01 feat: V0 pre-fab review fixes and JLC order files
    Review 2026-09-29 to 2026-10-01 (docs/12, hardware/ToDo.md):
    - Relays G5LE-1 -> Omron G2RL-1-E DC5 (5 kV coil-contact, 8 mm) for 230 V
    outdoors; Würth 691137710003/-10002 screw terminals; mains rules per relay
    in the .kicad_dru, MAINS track width 2.5 mm, 10 A per channel
    - PoE bridges 4x V6K100 -> 2x MB10S-50MIL; Ethernet pair polarity at J3
    fixed; W5500 1V2O cap 10 nF; ESP32 and +3V3A decoupling; CHASSIS network
    (1 M || 1 nF 2 kV, 0 R DNP); audio jack tip-only; USB-C shield on GND
    - Passives moved to JLC basic parts (Part-DB 589-609), LCSC numbers in
    Part-DB; U4/U5 on SOT-23-5; C19 re-placed; PoE/POWER clearances adjusted
    - produc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
    [OH_Node_V0_Prototype.kicad_pcb, OH_Node_V0_Prototype.kicad_sch, bom.csv, hand_parts.csv, positions.csv]
2026-10-01 chore: hand-parts list shows needed/in stock/to buy with THT cost totals
    [hand_parts.csv]
2026-10-03 chore: move components and do impedance matching
    [OH_Node_V0_Prototype.kicad_pcb]
2026-10-04 feat: V0 pre-fab ToDo fixes (audio jack, W5500, PS1, U3, amp, relays)
    - J1: LRV footprint with 0.8 x 1.5 mm slots per Same Sky layout
    - W5500: C15 moved to pin 28/29 with GND via
    - PS1: Ag9900 hand-soldering land pattern (datasheet fig. 22), outline on body
    - U3: +3V3 heat-spreader zone on F.Cu; solid zone connection rule for
    PS1 pad 2, C2 pad 2, U3 pin 1
    - 3V3 distribution widened to 0.5 mm
    - U6: outputs 0.6 mm, 4 GND vias in exposed pad, C21 100 uF bulk
    - Relays: mains_between_relays 4.0 mm rule, loops moved (min 4.8 mm)
    - ToDo: progress notes, order files moved to last step
    [OH_Node_V0_Prototype.kicad_pcb, OH_Node_V0_Prototype.kicad_sch]
2026-10-04 feat: V0 minor ToDo items (relay FETs, bleeder, labels, ERC)
    - Q1/Q2: DMN2004DWK-7 (VGS(th) <= 1.0 V) instead of DMN601DWK-7
    - R20: DNP 100R 2512 bleeder on +5V for the Ag9905 200 mA min load
    - C21 bulk at U6; relay terminal labels centred per pin
    - ERC: U6 exposed-pad exclusion, PS1 cached ki_fp_filters fixed
    - docs/12: auto-MDIX, G2RL pinout, V1 deferrals, FET and audio rows
    - ToDo: progress notes, JLC preview moved to last step
    [OH_Node_V0_Prototype.kicad_pcb, OH_Node_V0_Prototype.kicad_sch]
2026-10-04 feat: V0 status LEDs and PoE + USB analysis
    - D1 yellow (GPIO36, STAT) and D2 red (GPIO35, ERR) with R45/R46 1K,
    silkscreen labels; docs/12 pin plan updated
    - docs/12: PoE and USB at the same time (D10 OR-ing, worst case, bench checks)
    - ToDo: status LEDs and PoE + USB closed, BOM note extended
    [OH_Node_V0_Prototype.kicad_pcb, OH_Node_V0_Prototype.kicad_sch]
2026-10-05 feat: V0 layout review fixes (clock spacing, widths, stitching, test points)
    Works through the external layout review of 2026-10-05 in hardware/ToDo.md:
    - DRC rules min_track_width (0.15) and clock_3w (SCLK/I2S clocks 0.4 mm, U1
    fan-out fenced by rule area clk_fanout_U1); Default class 0.2 mm, SPI/I2S
    respaced, thin tracks widened or rerouted
    - GND zone 0.2/0.15/0.3/0.3; +3V3A feed moved off the ETH pair; crystal caps
    and ESP32 decoupling in the signal path; D9 in the VIN path; C34 22u input
    cap at the AMS1117
    - USB and ETH_RXT on JLC04161H-7628 widths (90R 0.247, 100R 0.183), USB skew
    tuned; GND vias at SMD GND pads, signal return vias, doubled supply vias
    - test points TP1-TP8, m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
    [OH_Node_V0_Prototype.kicad_pcb, OH_Node_V0_Prototype.kicad_sch, hand_parts.csv, hand_parts_digikey.csv]
2026-10-05 feat: V0 moves to 12 V (AG9912 + AP63205 buck), 12 V sensor terminals
    The PIR terminals now carry 12 V for the haunt's 12 V motion sensors, which
    switch a contact to GND:
    - PS1 AG9912-MTB (12 V, 12 W to 70 °C, min load 100 mA); C2 100u/25V
    polymer, C3/C4 22u/25V at the module output; bleeder R20 removed
    - U7 AP63205WU-7 buck 12 V -> 5 V (L2 4.7 uH, C35 in, C36/C37 out, C38
    bootstrap), placed under PS1 and feeding the existing +5V trunk
    - J8/J10 pin 1 on +12V through PPTCs F1/F2 (0805L020/30XR); signal inputs
    get a 10K pull-up at the terminal and 10K series (was 1K series, 100K
    pull-down), so contacts to GND (NO/NC) and active 3.3 V outputs both work
    - +5V trunk rerouted around J8/J1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
    [OH_Node_V0_Prototype.kicad_pcb, OH_Node_V0_Prototype.kicad_sch]
2026-10-05 feat: V0 GND stitching, +12V sensor feed moved to the mains clearance limit
    - +12V run to F1/F2 moved from y 124.35 to y 126.0, right at the
    mains_to_selv limit; removes a 0.5 mm GND sliver between +5V and +12V and
    an F.Cu GND island with no via
    - 209 GND stitching vias (0.6/0.3, hexagonal 5 mm like the KiCad via
    stitching plugin, plus a gap pass), each inside the GND fill on all four
    layers, marked free so they keep their net
    - max path through copper to a GND via: F.Cu 55.8 -> 10.1 mm,
    B.Cu 29.0 -> 10.6 mm; DRC 0 errors, parity clean
    [OH_Node_V0_Prototype.kicad_pcb]
2026-10-05 chore: V0 silkscreen cleanup, DRC fully clean
    Silkscreen overlaps and silk-over-copper fixed in the board; six
    silk_edge_clearance hits at the top board edge (y 70) excluded. DRC now reports
    no errors and no warnings, parity clean.
    [OH_Node_V0_Prototype.kicad_pcb]
2026-10-05 feat: V0 enclosure (OpenSCAD base, hood, SW1 push pin)
    Wall-mount base and hood screwed through the board's mounting holes with
    M2.5 heat-set inserts, LED skin over D1/D2, print-ready STLs, a board STL
    export script (pcb.stl, gitignored) and a collision check against the board's
    3D models.
    [base.stl, enclosure.scad, hood.stl, pin.stl]
2026-10-05 feat: V0 JLC order files regenerated for the 12 V board
    production/jlc_final/ rebuilt on 22dd484:
    - gerbers and CPL from the Fabrication Toolkit plugin (CLI, same options);
    CPL reduced to the 102 SMD parts in the BOM
    - BOM from make_bom.py: 41 lines, every line with an LCSC number
    (Q1/Q2 C156343 added to Part-DB)
    - hand-soldered parts split by source: Würth Elektronik direct
    (hand_parts_wurth.csv) and DigiKey (cart upload, AG9912-MTB now)
    - README: part counts, extended and thin-stock parts, preview checklist
    incl. U7 and Q1/Q2, DNP list incl. R47/R48/R50
    make_bom.py and hand_parts.py parse footprint attributes per footprint
    block. The old forward regex took the next footprint's at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
    [bom.csv, hand_parts.csv, hand_parts_digikey.csv, hand_parts_wurth.csv, positions.csv]
2026-10-05 feat: V0 schematic and second layout review, order files regenerated
    Schematic:
    - R20/R49 10K pull-downs on /WS_OUT1 and /WS_OUT2, so the AHCT buffers
    hold their outputs low while the ESP32 is in reset, boot or download mode
    - J12 pin 2 is 3V3 instead of GPIO1; U2.39 carries a no-connect flag
    - power symbols match their rails; the analog rail is renamed +3V3A ->
    +3.3VA (stock symbol), with the netclass pattern and the board renamed
    Layout:
    - C3 moved next to PS1 on the +12V track; C4 stays at the buck input
    - via removed from the PS1.2 pad, two rows of GND vias beside it instead
    (Ag9900 Fig. 12; the Fig. 17 keep-out is mechanical, not a via ban)
    - ring of eight GND vias at J7.2, J8.2,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
    [OH_Node_V0_Prototype.kicad_pcb, OH_Node_V0_Prototype.kicad_sch, bom.csv, positions.csv]
2026-10-05 fix: V0 CPL placement offsets from JLC's preview
    JLC's preview showed several parts off; the corrections are footprint
    fields read by the Fabrication Toolkit plugin, set in schematic and board
    so they survive the next regeneration:
    - U2 (ESP32-S3 module) and J11 (USB-C): FT Origin = Center. JLC's models
    sit on the pad centre, KiCad's anchors do not; the module was 3.6 mm
    towards the antenna. U2 also gets FT Position Offset 0,0.12, matched to
    a zoomed preview.
    - Q1/Q2, U4/U5, U7: FT Rotation Offset +90; U6: -90. The plugin's
    transformations.csv left these 90 degrees off for JLC's models.
    README: the 21 extended lines as JLC classified them, the offsets, how
    diode and bridge polarity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
    [OH_Node_V0_Prototype.kicad_pcb, OH_Node_V0_Prototype.kicad_sch, positions.csv]
2026-10-05 fix: V0 via removed from Y1's GND pad, gerbers regenerated
    The GND via at (136.83, 97.47) sat on Y1 pad 2; replaced by three GND vias
    beside the crystal. Gerbers differ from the previous set only by this via
    change; BOM and CPL regenerated and unchanged. DRC 0, parity clean. A scan
    of all SMD pads finds no other via in a pad apart from the intended
    thermal vias under U2 and U6.
    [OH_Node_V0_Prototype.kicad_pcb]
2026-10-05 feat: V0 hand-parts order lists with spares
    hand_parts.py --spares adds spares per line by unit price: 1 from EUR 5
    (PS1 AG9912-MTB, J3 magjack), 2 from EUR 1 (relays), 3 below (jack,
    terminals, header). Order quantity and cost use the price tier of the
    order quantity. Lists regenerated for 5 boards: DigiKey EUR 124.54,
    Würth direct four lines.
    [hand_parts.csv, hand_parts_digikey.csv, hand_parts_wurth.csv]
2026-10-17 feat: V0.2 board, power-bank capable, with line out and order files
    Second revision of the V0 prototype:
    - 5 V AG9905 PoE module, TPS2121 power mux (PoE preferred, USB/power bank
    fallback) in XREF mode with a CJ431 reference for 5 us switchover, MT3608
    boost to 12 V for the PIR terminals and J12
    - PCM5102A line out on a Kycon STX-3000 with a ferrite-filtered AVDD/CPVDD,
    MAX98357A on a speaker terminal playing (L+R)/2
    - 12 V tolerant PIR inputs, six status LEDs, reset button, PS1 thermal vias,
    GND stitching
    - docs/10 D37 amendments, docs/12 V0.2 sections, ToDo for V0.2
    - JLC order files regenerated: 154 SMD parts, 54 BOM lines, hand-parts lists
    - datasheet manifest for the new parts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
    [OH_Node_V0_Prototype.kicad_pcb, OH_Node_V0_Prototype.kicad_sch, bom.csv, hand_parts.csv, hand_parts_digikey.csv, hand_parts_wurth.csv, positions.csv]
2026-10-17 fix: V0.2 GND vias and U2 GPIO38/WS_OUT2 swap, order files regenerated
    - U2 pads 11 and 31: GPIO38 and WS_OUT2 swapped in the schematic and the
    board updated to match
    - GND vias: new vias at U10, R61, D16, C43 and R7, and in the rework around
    U9 and the WS_OUT2/GPIO38 routing; the via next to the U1-XO track moved
    to (132.9, 97.35) for clearance
    - C45/C48, R71, C35, L2, R7 and U7 moved
    - zone defaults in the project file changed for new zones
    - gerbers and CPL regenerated from the board saved 23:28: DRC 0 errors,
    0 unconnected, parity clean; BOM unchanged (154 SMD parts, 54 lines)
    [OH_Node_V0_Prototype.kicad_pcb, OH_Node_V0_Prototype.kicad_sch, positions.csv]
2026-10-17 fix: V0.2 vias out of pads, GPIO18 label and silkscreen, gerbers regenerated
    - two vias moved out of pads
    - J12 pin 5 label fixed to GPIO18 (U2 pin 11); WS_OUT2 stays on GPIO38
    (U2 pin 31); docs/12 pin plan updated for the swap
    - silkscreen fixes
    - gerbers regenerated from the board saved 23:47: DRC 0 errors,
    0 unconnected, parity clean; BOM and CPL unchanged (154 SMD parts)
    [OH_Node_V0_Prototype.kicad_pcb, OH_Node_V0_Prototype.kicad_sch]
2026-10-17 fix: V0.2 CPL rotation offsets for U7 and U8 from JLC's preview
    FT Rotation Offset +90 on U7 (MT3608) and -90 on U8 (TPS2121), in the
    schematic and carried to the board. The order at tag v0.2 had both rotated
    in JLC's placement editor instead. GPIO18 re-routed on the board (17
    segments, 3 vias). DRC 0 errors, 0 unconnected, parity clean.
    [OH_Node_V0_Prototype.kicad_pcb, OH_Node_V0_Prototype.kicad_sch]
2026-10-18 feat: V0.2 enclosure, V0.1 enclosure printability fixes, 3MF plates
    New enclosure for the V0.2 board in enclosure/v0.2: USB-C, RJ45 and the
    STX-3000 line-out jack at their new top-edge positions, speaker terminal
    J13, push pins for SW1 (BOOT) and SW2 (RST) with engraved labels, LED
    windows for D3/D4/D14/D15/D16/D17, lid slot for J12, relief for R50 under
    the H4 post. The V0.1 enclosure moves to enclosure/v0.1 and exports its
    board from the v0.1 tag.
    Both enclosures:
    - base keeps its wall below the parting plane and the tab gussets moved;
    V0.1 base.stl had a 2.4 mm3 floating sliver at the right-hand tab
    - insert bore 4.0 (CNC Kitchen / ruthex M2.5), 6.7 deep and closed at the
    bottom, bos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
    [OH_Node_V0.1_enclosure.3mf, OH_Node_V0.2_enclosure.3mf, base.stl, enclosure.scad, hood.stl, pin.stl]
2026-10-19 V0 prototype boards: W5500 Ethernet, built-in I/O, both revisions
    oh-node-v0.1 and oh-node-v0.2: ESP32-S3-WROOM-1-N16R2 with quad PSRAM,
    USB Serial/JTAG console. A V0 node describes its soldered-on I/O as
    module 0x0F01 "Node V0" (source "board"): four relays, two sensor
    terminals that read true for a closed contact on both revisions, two
    strips. The ports are identical on both, so the console makes one
    fixture type; the revisions differ only in their bindings.
    The W5500 runs on SPI2 at 20 MHz with the chip's own Ethernet MAC.
    Wi-Fi now also takes over when the link drops after boot, not only
    when it never came up. A separate error LED double-flashes faults;
    the V0.2 indicator LEDs follow th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
    [oh_app.c, oh_app.h, oh_board.c, oh_board.h, oh_eth.c, oh_module.h, oh_net.c, oh_status.c]
2026-10-19 Audio: stored clips and an RTP stream, played at a show time
    A V0 node now makes sound, per OpenHaunt/node doc 13. Clips are RIFF WAVE
    (PCM16 or IMA ADPCM, any rate) on a FAT partition, named by sha256 and
    uploaded over PUT /api/v1/audio/clips/<sha>. An RTP L16 stream is played by
    its mapping to show time. Four clip voices and the stream are mixed at
    48 kHz and started, stopped and faded on openhaunt/<sn>/audio/*, and the
    node reports back on audio/status.
    Every sample is placed by its show time. The I2S on_sent interrupt
    timestamps each DMA buffer as it leaves for the DAC, so the mixer is told
    when the frame it writes will be heard, and nothing else. That makes it a
    pure function, which th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
    [esp32s3-16mb.csv]
2026-10-19 Pixel strips: drawn by the node or read from sACN, each strip a head
    Each of a V0's two strip outputs runs in `effect` mode, where the node draws
    every pixel from nine ports (colour, brightness, colour 2, effect, speed,
    size, reverse, mirror, segments; ten effects worked out from the console's
    clock, so two strips agree), or in `sacn` mode, where it maps up to 1024
    pixels over as many universes as they need. The mode is set with
    PUT /api/v1/pixels/<n> and kept in NVS (OpenHaunt/node doc 14).
    A port can now name its head, so each strip is a fixture of its own and both
    carry the color and intensity classes. The mDNS TXT record carries `desc`, a
    checksum over the description, so a console know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
    [oh-pixels.py, oh_app.c, oh_app.h, oh_drivers.h, oh_e131.c, oh_e131.h]
2026-10-20 Brokers: a list, leader first, walked when the one a node is on goes
    A console that fails over hands its nodes every station's broker, leader first,
    in POST /api/v1/config (mqtt.brokers) and on the retained openhaunt/brokers. The
    node keeps it in NVS, walks it in order when its broker drops (200 ms between
    entries, 1 s doubling to 8 s after a whole pass), and moves at once when a new
    list names another leader. oh_brokers in oh_core is the walk and the parsing,
    with host tests; oh_mqtt runs esp-mqtt with auto-reconnect off and points the
    client itself. mqtt.broker alone is still a list of one. Version 0.4.0.
    Unverified on hardware.
    [oh_brokers.c, oh_brokers.h, test_brokers.c]
2026-10-20 American English: color, catalog, and the port names that say it
    Docs, comments, identifiers and the built-in modules' port display names
    ("Strip color", "Color", "Color 2"). Wire field names were already
    American. Kept: ESP-IDF's own wear_levelling component name.
2026-10-24 feat: V0.1 test firmware in test/firmware
    PlatformIO bring-up firmware for the V0.1 board: W5500 Ethernet (ESP-IDF
    driver with a patched RX buffer setup), Wi-Fi and mDNS, relays, I2S audio
    and RTP live stream, WS2812/WS2815 outputs, PIR inputs with actions, web UI
    with SSE live updates, OTA. Not yet adapted to the V0.2 pin and PIR
    changes; the README lists what differs.
2026-10-24 American English in the docs and the hardware notes
    Kept: vendor part descriptions inside the KiCad files.
    [enclosure.scad]
2026-10-24 13 — A node may name its stream port
    Several simulated nodes on one machine all listened on 5004, so the first heard
    every other node's stream. stream.port is optional; absent is still 5004.
2026-10-24 Setup AP: a DNS server for the phone, and a stack the scan fits in
    Two defects found by the first phone to join a V0.1's setup AP.
    The AP's DHCP server offered no DNS server — IDF offers none unless told — so a
    phone could never reach the captive DNS: its portal check failed as "no
    internet", no sign-in page came up, and Android routed 192.168.4.1 over mobile
    data. The AP now offers itself.
    And the setup page's Wi-Fi scan overflowed the HTTP task's 8 KB stack, which
    rebooted the node and took the AP away from under the phone. 12 KB, the size the
    serial console has always scanned on; a scan now logs what it left (3.9 KB).
    [oh_net.c]
2026-10-24 14 — Pixel effects, exactly, and as bytes
    A strip in effect mode is now drawn in two places: on the node, and in a console
    showing what the strip is doing (the-pult's plan and 3D view). Words were enough
    for one implementation and are not for two, so doc 14 gains the arithmetic —
    phase, position, hash, noise, every effect's level, the bytes — and a corpus:
    600 cases, every effect under five parameter sets at six moments, as the bytes
    oh_pixfx.c draws.
    The corpus is generated by test/host/pixfx_corpus.c and checked by
    test_pixfx_corpus, exactly, so a change to an effect is a decision the corpus
    records rather than a drift a console finds. Another implementation must land
    within a byte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
    [pixfx_corpus.c, test_pixfx_corpus.c]
2026-10-25 V0.1 keeps its amplifier on, so its line out does not hum
    On V0.1 the MAX98357A's SD_MODE is GPIO48 and its outputs go to a 3.5 mm
    jack, usually into another amplifier. The amplifier was powered just ahead
    of a sound and shut down two seconds after; in shutdown its outputs are
    high-impedance, so the next amplifier's input floated and hummed.
    OH_AUDIO_AMP_ALWAYS_ON (default on for V0.1) keeps it powered and fed the
    silence the I2S channel already sends, which holds the line at zero. V0.2,
    whose amplifier drives a speaker terminal and whose line out is the
    PCM5102A, still switches it off to save the power bank. The on/off rule is
    oh_amp in the core, with host tests.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
2026-10-27 A node that crashed says so, and hands over its core dump
    The 16 MB table has had a coredump partition and sdkconfig.defaults has
    turned core dumps on since the firmware moved here, but nothing was ever
    written: MINIMAL_BUILD leaves out a component nobody requires, espcoredump
    was one, and with it went the Kconfig those three lines set. The build only
    warned that the symbols were unknown.
    oh_http requires it now, for two things a node needs when it reboots on its
    own: /status says `resetReason` and whether a `coredump` is in flash, and
    GET /api/v1/coredump returns it raw, for `esp-coredump info_corefile
    --core-format raw` against the ELF of the image that crashed, without a USB
    cable. DELET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
2026-10-27 Show time is right from the first second, and SNTP cannot move it
    Two ways a V0.2 ran its show time off the console's, both found by a stream
    that would not play.
    The retained openhaunt/clock seeds the estimate, and may be seconds old after
    a console restart. The first live sample only corrected it by the 50 ms slew
    limit, so show time ran 5% fast for up to 75 s after every connect, and a
    stream jumped all the while. The first live sample now replaces a retained
    seed outright, as it does an empty estimate; smoothing starts from there.
    And the estimate was taken against oh_clock_now_ms(), which steps by the
    whole of unix time when SNTP first sets a clock that was counting from boot.
    On Wi-F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
    [oh_clock_sync.c, oh_clock_sync.h, test_clock_sync.c]
2026-10-27 D38 — On V0, Wi-Fi stands by beside the cable
    Pulling a V0.2's cable took it off the network for 30 s plus an
    association: Wi-Fi only started as a fallback, and the cable's link was
    checked every 2 s. With credentials, Wi-Fi now comes up at boot beside the
    cable and both stay up. The cable is preferred while its link is up and
    Wi-Fi carries everything the moment it is not. Without credentials Wi-Fi is
    the fallback still, to open the setup AP.
    - The node is up while either path is. Each path used to set the state on
    its own, so an access point rebooting took a cabled node off the broker,
    and the cable's address timing out two minutes after a pull marked a node
    on Wi-Fi down, after wh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
    [oh_eth.c, oh_json.c, oh_json.h, oh_net.c, oh_net.h]
2026-10-27 What a V0.2 has done so far, on a bench against the-pult
    The firmware README said no V0 board had run this firmware. One has now: a
    V0.2 against the-pult on 2026-10-26, over Ethernet and Wi-Fi and the moves
    between them, adoption and MQTT, the broker list across a console restart,
    the relays and their LEDs, the status LEDs, the line out, clips and an RTP
    stream, show time, OTA and a core dump read back over HTTP. Its Status
    section says so, and says what has not run yet: the sensor terminals, both
    strips, the speaker, a redundant stream, and the V0.1.
    Two open notes in docs/12 are closed by it. The STX-3000 pinout read from
    Kycon's drawing is right: a 440 Hz tone on the left channel only ca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
2026-10-27 pult-call.mjs exits when it has its answer
    It printed the result, closed the socket, and eight seconds later said
    "timeout" and exited 1 anyway: the timer was never cleared.
2026-10-27 V0.2 plays left out of the tip again: the STX-3000 pads were right first
    The first V0.2 board, on 2026-10-26, played the left channel out of the
    ring. The T and R pad names on J1 had been swapped on 2026-10-17 on a
    reading of Kycon's drawing; pins 2 and 3 sit at the same depth, so the
    symbol was the only evidence, and the reading was wrong. The pad at
    (-4.25, -5.3) is the tip.
    The footprint is back the way it was first drawn, with the measurement in
    its description. /AUD_L and /AUD_R now end on each other's pads and DRC
    reports the short until J1's two traces are re-routed (hardware/ToDo.md).
    The boards already built are put right in firmware: OH_AUDIO_SWAP_LR,
    default on for V0.2, swaps t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
    [OH_Node_V0_Prototype.kicad_pcb]
2026-10-27 Enclosures: countersunk screws from stock, a taller BOOT pin, room for wide USB plugs
    Both V0 enclosures, after the first prints:
    - The lid takes DIN 965 M2.5 x 25 countersunk screws (Part-DB 285, in stock)
    in a 90° countersink instead of ISO 14580 cheese heads that had to be
    ordered. `countersunk = false` brings the flat seat back.
    - BOOT stands 2.0 mm out of the lid, RST stays at 1.0, so V0.2 prints two
    different pins (`pin_i`).
    - The USB-C opening is 13 x 8 mm for the overmold of wide cable plugs
    (10 x 6.5 before; `usb_w`/`usb_h`).
    - LED windows are open holes (`led_skin = 0`), so any filament color works.
    make_3mf.py lays out any number of enclosures, one row each, with a list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
    [OH_Node_V0.1_enclosure.3mf, OH_Node_V0.2_enclosure.3mf, enclosure.scad]
2026-10-27 Enclosures: plates with several at once for the Prusa XL
    build_plate.sh lays two V0.2 enclosures and one V0.1 on one plate,
    build_plate_3x0.2.sh three V0.2, each with the print check. Both reuse the
    folders' enclosure.scad and make_3mf.py's rows.
    The sliced .bgcode files are regenerated from the 3MFs and stay out of git.
    [OH_Node_V0_2x0.2_1x0.1_enclosures.3mf, OH_Node_V0_3x0.2_enclosures.3mf]
2026-10-27 V0 numbers its sensors from the bottom, like its strips
    The two PIR terminals sit above the two strip terminals on the right edge,
    and the strips count from the bottom: strip 1 is the lowest. The sensors
    now do the same on both revisions, so one harness and one wiring diagram
    fit either board.
    V0.2 already did: its lower terminal (J10, silkscreen "PIR1") is GPIO15,
    sensor 1. V0.1 routes the lower terminal to GPIO16, so its
    OH_PIN_SENSORS is now "16,15". V0.1 has no sensor LEDs to follow.
2026-10-27 V0: a wiring diagram for the terminals, seen on the lid
    wiring_terminals.svg shows which screw of each relay, PIR and WS2812
    terminal is what, where it sits on the enclosure, and how the firmware
    numbers it. It is the same for V0.1 and V0.2: the terminals, their places
    and their pin order are the same on both boards (netlists of tags v0.1 and
    v0.2), and the window positions come from the enclosures' scad files.
2026-10-27 Revert "V0.2 plays left out of the tip again: the STX-3000 pads were right first"
    This reverts commit 29feacd.
    The jack was right. On 2026-10-27 the V0.2 f674a578 played a spoken
    "left" on the left channel only and "right" on the right only, through
    its 3.5 mm line out into headphones: with OH_AUDIO_SWAP_LR on, each word
    came out of the wrong side; built with it off, each came out of the side
    it names. That agrees with Lukas's 440/880 Hz test of 2026-10-26.
    So the footprint goes back to the 2026-10-17 pads, the firmware no longer
    swaps, and J1's traces need no re-route. The kicad-custom-libs footprint
    was changed with 29feacd too and is not reverted here.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
    [OH_Node_V0_Prototype.kicad_pcb]
2026-10-27 Web UI: live state over server-sent events instead of a 2 s poll
    The page polled /status every 2 s, so a PIR that tripped showed up to two
    seconds late, or not at all if it was short. GET /api/v1/events is now a
    text/event-stream: `ports` within 50 ms of any port changing (and at the
    renderer's 4 Hz while one traces a shape), `status` on connect, on network,
    broker, error or config changes and every 5 s, and `module` when the node
    binds its I/O again. The page follows it and falls back to polling where
    the stream is missing.
    Each stream is an esp_http_server async request, written by one task; the
    server neither selects nor LRU-purges its socket. Two at a time, each holding
    one of the serve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
2026-10-27 V0: BOOT toggles dark mode, and the web UI shows the button
    A press of BOOT (GPIO0, two 50 ms ticks the same way round) turns every
    indicator LED off: status, error, and on V0.2 the relay and sensor LEDs.
    Identify still blinks, so a dark node can be found. Another press lights
    them again. docs/12 had "dark mode is firmware"; there was none until now,
    and nothing read the button.
    Dark is a config key: kept in NVS, so a node that reboots mid-show stays
    dark from its first tick, and set with POST /api/v1/config {"dark": true}
    or the web UI's Dark mode button. /status carries `dark` and
    `buttonPressed`, so the event stream shows a press as it happens. The press
    is posted as OH_EVENT_BUTTON and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
    [oh_status.c, oh_status.h]
2026-10-27 docs: the STX-3000 pinout is confirmed by ear, not with a meter
    docs/12 and the ToDo asked for a plug and a meter. That has not happened;
    two listening tests on a built V0.2 stand in for it (tones on 2026-10-26,
    a spoken left/right on 2026-10-27, once with the firmware swapping the
    channels and once without). docs/12 also records that the swap back in
    29feacd was wrong and is reverted, here and in the LRV footprint.
2026-10-27 /status and the web UI show the chip's temperature
    The ESP32-S3's own sensor only reached MQTT health (temp_c). It moves to
    oh_board, installed once at boot behind oh_board_chip_temp(), since the chip
    has one sensor and a second install fails; health and /status both read it
    there. /status carries chipTempC to a tenth of a degree, and the Status card
    shows it. It is the die's temperature, well above ambient: 46.7 °C on the
    V0.2 on the bench, the same in /status, on the event stream and in health.
    [oh_board.c, oh_board.h]
2026-10-27 V0.2: a sensor LED is lit while its sensor is triggered
    The LED beside each PIR terminal followed the pin: lit while the contact was
    closed to GND. That is the trip only for a normally open contact. An NC
    contact lit it while idle and darkened it on a trip, and so did a sensor
    that drives 3.3 or 12 V on motion, whatever invert its port had.
    It shows the port's value now: oh_status finds the gpio_in binding on each
    sensor pin when a module is bound (the built-in V0 module or a virtual one)
    and lights the LED while that port is true. A terminal no port reads still
    shows its pin. Relay LEDs keep following their pins; dark mode turns all of
    them off as before.
    First run of the V0.2 sensor term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
    [oh_status.c]
2026-10-27 /status and /info name the build: commit and build time
    fw is version.txt and stays 0.4.0 from one build to the next, so there was
    no way to tell from outside whether a node runs the latest image. Each build
    now writes the short commit (with -dirty for uncommitted changes) and the UTC
    build time; /status, /info, the web UI, the console and the boot log show
    them. /info adds them outside oh_json_info, so the TXT desc checksum does not
    change with a rebuild.
    [oh_app.c, oh_app.h]
2026-10-28 A stream says which packets never reached the node, and how long its receiver waited
    `missing` says a frame was not in the buffer when it was played; it cannot say
    whether its packet ever reached the node. `audio/status` now carries, per
    session: `packets`, `seq_lost` (skipped by RTP sequence and never seen since),
    `reordered`, `duplicates`, `foreign` (another ssrc), and `rx_gap_ms` /
    `rx_gap_max_ms`, the longest the receiving task went between two packets in
    the last second and in the session. A gap over the UDP socket queue's six
    packets (30 ms of a 5 ms stream) is the stack dropping them while the task was
    not run; a sequence gap with short waits is the wire. Each gap is also a
    warning on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
    [oh_audio.c, oh_audio_proto.c, oh_audio_proto.h, oh_rtp.c, oh_rtp.h, test_rtp.c]
2026-10-28 The stream's socket holds 160 ms and its reader is not starved
    Measured at HHG with the new counters: every packet that never reached the
    node followed the receiving task going 39-50 ms without one, every couple of
    seconds — past the UDP socket's stock six-packet queue (30 ms of a 5 ms
    stream), so lwIP dropped the next packets and the node played a hole.
    CONFIG_LWIP_UDP_RECVMBOX_SIZE is 32 (160 ms) with SO_RCVBUF to match, and the
    receiver runs at 17, just under lwIP's own task, where at 12 it waited behind
    system work.
2026-10-29 Doc 16: a show a console puts on a node, which runs it alone
    Designed on 2026-10-29, nothing built. One flow and up to four timelines
    as a package on the clips FAT: the console's flow kinds interpreted in
    oh_core (plus Started), tracks played stepwise on the render tick, clips
    on the mixer by the node's own clock. A mode the console switches and NVS
    keeps, not a fallback; output and audio commands are ignored while it
    runs, the package pins its clips, a bad one does not start. Doc 08's
    standalone section points at it and says the crashed-server case is
    still open.
2026-11-02 A node's name reaches the router and the switch, and it hears which port it is on
    The friendly name, folded into a DNS label (Coffin Room DMX → coffin-room-dmx,
    umlauts spelled out), is the DHCP hostname, renewed at once on a rename, and a
    second mDNS hostname beside openhaunt-<sn>.local, which stays, as do the
    service instance the-pult reads the serial from and the setup AP's SSID. A
    node without a name keeps openhaunt-<sn>.
    On the cable the node sends LLDP every 30 s and at once on a rename or link
    up: the name as System Name, module and firmware as description, its IP as
    management address. It reads the switch's LLDP too, and /status carries
    network.switch (name, port, management IP, a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
2026-11-02 A node's ports and heads can be named, beside the names the module gives them
    "Ausgang PIR", "LED Streifen Tor", "Relay Horn": POST /api/v1/config takes
    {"labels":{"ports":{"4":"…"},"heads":{"1":"…"}}} as a partial merge, an empty
    string clearing one, and /api/v1/info carries `label` beside `name` where one is
    set. A label never replaces `name`, which is the module's word for a port and
    what a console keys it by. A body naming a port or head the node does not have,
    or a label over 31 bytes or not readable UTF-8, is refused whole.
    Kept in NVS as the JSON /config takes and read back through the same validation,
    by number and not tied to a module. In the `desc` checksum, so a console learn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
    [oh_app.c, oh_json.c, oh_json.h, oh_labels.c, oh_labels.h]
2026-11-02 Firmware 0.5.0
    What a node does over 0.4.0: ports and heads named beside the module's names
    (`labels` in /config, `label` in /info), which the-pult 0.2.0 reads and writes;
    its name in DHCP, a second mDNS hostname and LLDP; the build in /status and
    /info; a V0.2 sensor LED lit while its sensor is triggered; and a stream socket
    deep enough not to drop packets.
    Tagged firmware-v0.5.0: v0.1 and v0.2 are the boards.
2026-11-02 README: prototypes validated and tested, the-pult, docs 12 to 16
    The README still described the concept stage. It now gives the V0 status,
    the decisions through D38, internal flash only, and the docs added since.
    the-pult is named as the console, and the protocol as open to any software.
    Docs 08 and 09 carry their own numbers in the heading, and the firmware
    README links doc 08 on this branch and lists the V0 boards as tested.
